Minssuung/BandLeadDevice/work_process/0_1.md

# 0_1. IMU 센서란?

> **핵심 질문: IMU는 "기울기"를 어떻게 측정하는가?**

---

## IMU(Inertial Measurement Unit)란?

IMU는 물체의 **움직임과 방향**을 측정하는 센서 모듈입니다.
내부에 보통 아래 3가지 센서가 함께 들어있습니다.

---

## 구성 센서 3가지

### 1. 가속도계 (Accelerometer)
- **무엇을 측정하나:** X, Y, Z 3축 방향의 가속도 (단위: m/s² 또는 g)
- **특징:** 정지 상태에서도 중력(g = 9.8 m/s²)을 측정함
  - 센서가 수평이면 Z축에만 중력이 걸림
  - 기울어지면 중력이 X, Y, Z에 분산됨
- **용도:** 정적(느린) 기울기 측정에 강함
- **단점:** 진동이나 충격에 민감 → 흔들리면 노이즈 발생

### 2. 자이로스코프 (Gyroscope)
- **무엇을 측정하나:** X, Y, Z 3축의 **각속도** (단위: °/s, 초당 몇 도 회전하는가)
- **특징:** 회전 속도를 측정 → 시간으로 적분하면 각도를 얻을 수 있음
- **용도:** 빠른 회전 동작 추적에 강함
- **단점:** 시간이 지날수록 오차가 누적됨 → **드리프트(drift)** 현상
  - 가만히 놔둬도 값이 천천히 변함

### 3. 지자기계 (Magnetometer)
- **무엇을 측정하나:** 지구 자기장의 방향 (나침반 역할)
- **용도:** Yaw(수평 회전) 각도의 절대 기준 제공 → 드리프트 보정
- **단점:** 주변 금속/전자기기에 영향받음 (실내에서 정확도 낮을 수 있음)

---

## 핵심 답변: IMU는 기울기를 어떻게 측정하는가?

```
가속도계 단독으로는:
  → 중력 방향을 기준으로 Roll(좌우 기울기), Pitch(앞뒤 기울기) 계산 가능
  → 하지만 흔들리면 부정확

자이로스코프 단독으로는:
  → 회전 속도를 적분해서 각도 추정 가능
  → 하지만 시간이 지나면 드리프트 누적

둘을 합치면 (센서 퓨전):
  → 가속도계로 저주파(느린 움직임) 보정
  → 자이로로 고주파(빠른 움직임) 추적
  → 서로의 단점을 보완 → 정확한 각도 출력
```

> **WT61C-TTL은 이 센서 퓨전을 내부에서 자동으로 처리해서
> Roll / Pitch / Yaw 각도를 바로 출력해줍니다.**

---

## Roll / Pitch / Yaw 란?

| 용어 | 회전축 | 일상 표현 |
|---|---|---|
| Roll | X축 | 좌우로 기울이기 (비행기 날개 기울기) |
| Pitch | Y축 | 앞뒤로 기울이기 (비행기 기수 올리기) |
| Yaw | Z축 | 수평 회전 (나침반 방향처럼 돌리기) |

---

## WT61C-TTL이 출력하는 데이터

| 데이터 | 항목 | 단위 |
|---|---|---|
| 가속도 | Ax, Ay, Az | g |
| 각속도 | Wx, Wy, Wz | °/s |
| 오일러 각도 | Roll, Pitch, Yaw | ° |

---

## 참고 자료
- [WitMotion WT61C-TTL 제품 페이지](https://www.wit-motion.com)
- [WitMotion GitHub SDK](https://github.com/WITMOTION/WitStandardProtocol_JY901)
