Minssuung/BandLeadDevice/work_process/미니_팔로우암_안정화_검증.md

# 미니 팔로우암 안정화 검증 (2026-06-11)

> 미니 팔로우암(=팔로워를 닮은 미니어처 조종용 팔, 리더암)으로 7축 텔레옵을 구현하고
> 통신·변환·안전·추종을 수치로 검증한 보고서.

## 0. 용어 정리

이 장치의 정확한 명칭은 **리더암(leader arm) / 마스터암**:
팔로워와 닮은 미니어처 팔을 **손잡이로 잡고 조종**하는 방식 (ALOHA / GELLO / SO-ARM 계열).
- "외골격(exoskeleton)"은 몸에 **착용**하는 형태를 가리키므로 부정확
- 컨트롤 분류: **joint-space retargeting** (리더 관절각 → 팔로워 관절각 1:1 복사),
  OpenArm ROS2 기준으로는 `forward_position_controller` 방식 + 자체 보간층

```
리더암 (사람이 손잡이로 움직임, 토크 OFF = 순수 엔코더)
  → 60Hz 폴링 (leader_arm.py / LeaderReaderThread)
  → 틱 차이 × 360/4096 × 부호 × 스케일 (+ 영점 오프셋)
  → 기존 안전 파이프라인 (동기화 보간 70°/s, 관절클램프, 충돌벽, freeze)
  → DYNAMIXEL 팔로워 7축
```

## 1. 하드웨어 식별 (실측)

| 항목 | 값 | 확인 방법 |
|---|-----|---|
| 서보 | **Feetech STS3215 계열** (다이나믹셀 아님) | P2.0 무응답 + P1.0 핑 응답, addr3=777 시그니처 |
| 프로토콜 | DXL Protocol 1.0 호환 프레임 @ **1M baud** | 전 baud 스캔 |
| 구성 | **양팔 × (ID1~7 관절 + ID8 그리퍼)** = 팔당 8축 | 어댑터 2개(CH343, 시리얼 5AE6053359 / 5AE6083659) 각각 ID1~8 응답 |
| 현재위치 레지스터 | **addr 56** (2B, 0~4095) | addr36은 상수(2640)=위치 아님, addr56만 ID별 상이·정지시 안정 |
| 포트 고정 | `/dev/serial/by-id/...5AE605...` / `...5AE608...` | ACM 번호 밀림 방지 (팔로워 OpenRB-150과 공존) |

## 2. 수치 검증 (실측 + 단위테스트)

### 2-1. 통신 성능 (실기기 측정)
| 항목 | 측정값 | 의미 |
|---|---|---|
| 8서보 일괄 읽기 | **2.5 ms/회** | 이론 최대 **400 Hz** |
| 운용 폴링 | 60 Hz (15ms 주기) | 충분한 여유 (6배) |
| 분해능 | **0.088°/틱** (4096틱/회전) | IMU 보정오차(수°)보다 1~2자릿수 정밀 |
| 체인 지연(이론) | 리더읽기 2.5ms + 틱 ≤50ms ≈ **~60ms** | IMU 경로(~100-150ms+센서융합)보다 짧음 |

### 2-2. 랩어라운드/변환 단위테스트 (6/6 통과)
0/4095 경계를 넘는 이동에서 ±360° 점프가 나지 않는지:
| 케이스 | ref→pos | 결과 | 판정 |
|---|---|---|---|
| 동일 위치 | 2048→2048 | 0.00° | ✓ |
| ±90° | 2048→3072 / 1024 | +90.00 / -90.00° | ✓ |
| **경계 넘는 +이동** | 4000→100 | **+17.23°** (–343 아님) | ✓ |
| **경계 넘는 -이동** | 100→4000 | **-17.23°** | ✓ |
| 경계 1틱 | 4095→0 | +0.09° | ✓ |

### 2-3. 기능 검증 (사용자 실기 확인 완료)
| 항목 | 결과 |
|---|---|
| 관절 순서 | 리더 ID1~7 = 팔로워 1~7, **1:1 매핑 맞음** |
| 부호 (반복 조정으로 확정) | `LEADER_SIGN = {1:-1, 2:+1, 3:-1, 4:+1, 5:-1, 6:+1, 7:-1}` |
| 영점 오프셋 | **모터5 = +90°** (시작 시 base 틱 이동 방식 → 팔로워/IMU모드 설정 불변) |
| 전체 7축 추종 | **사용자 확인 완료** ("오케이 확인완료") |
| 그리퍼(ID8) | 읽기/표시만 (팔로워 ID8=고정모터라 매핑 보류) |

### 2-4. 미실시 (리더 재연결 시 10초면 측정 가능)
- 정지 노이즈(p-p/σ): 검증 시점에 리더 USB 분리됨. 측정 스크립트 준비돼 있음.

## 3. IMU 웨어러블 vs 리더암 비교

| | IMU 웨어러블 | 리더암 |
|---|---|---|
| 측정 원리 | 자세(쿼터니언) → 보정축 분해 | 관절각 **직접 측정** (엔코더) |
| 보정 | functional 보정 + 2-포즈 재정렬 필요 | **불필요** (시작 시 기준 캡처만) |
| 짐벌락/드리프트 | 쿼터니언으로 해결했으나 지자기 환경 영향 | **원천 없음** |
| 정확도 | 보정축 오차 수° (어깨 8° 언더리드 잔존) | 0.088° 분해능, 축오차 개념 없음 |
| 갱신율 | ~30Hz (펌웨어 115200 후) | 60Hz (최대 400Hz) |
| 지연 | ~100-150ms | **~60ms** |
| 장점 | 장비 없이 맨팔 동작, 야외/이동 자유 | 정밀·즉답·무보정 |
| 약점 | 보정/장착 변동/센서융합 지연 | 장치 앞에 있어야 함 |

→ **리더암 = 정밀 기준기(ground truth)**: 같은 동작을 IMU와 리더로 비교하면 IMU 보정 오차를 정량 측정 가능.

## 4. 안전 (두 모드 공통 파이프라인 공유)

- 동기화 보간(경로모양 보존, 70°/s) · 관절클램프(±90~140°) · 팔꿈치 충돌벽(EEPROM 800틱)
- 리더 전용: 끊김 0.3s freeze → 복구 램프인 / **리더 오류 시 자동 전달중지** / 토크 OFF 강제(엔코더 모드)
- 전달 시작 시 모터5가 +90°로 부드럽게 이동(영점 정렬) — 정상 동작

## 5. 파일

| 파일 | 역할 |
|---|---|
| `esp_imu_pc_control/leader_arm.py` | FeetechLeader (open=핑+토크OFF, read_positions, wiggle_detect) |
| `esp_imu_pc_control/leader_scan.py` | 포트/baud/ID 자동 스캔 유틸 |
| `esp_imu_pc_control3.py` | LeaderReaderThread, 리더 연결 UI, "리더-팔로워" 전달 모드 (IMU 모드와 병존) |

---

# 부록: IMU 파이프라인 지그 검증 (리더암 = 기준기, 2026-06-11)

IMU 1/2/3을 리더암 링크(윗팔/아랫팔/손)에 고정하고 리더 엔코더(0.088°)를 정답으로
IMU 분해 파이프라인을 정량 평가. 리더 라벨로 **보정축 자동 추출**(fit_axes_from_compare.py,
합성데이터 검증: 축 복구 완벽·재평가 0.00°) 후 재분해.

## 결과 (운용범위 |각도|≤85°, 원형오차·상수오프셋 제거)

| 관절 | 동작범위 | RMS 오차 | 95%ile | 판정 |
|---|---|---|---|---|
| j1 어깨 | 128° | **1.74°** | 3.3° | ✅ |
| j2 어깨 | (대규모는 1차) | **0.90°** | 0.8° | ✅ (1차 대동작: 게인 0.995/상관 0.991) |
| j3 어깨 | — | **2.54°** | 4.6° | ✅ |
| j4 팔꿈치 | 209° | **10.6°** | 13.6° | ✅ (10Hz 빠른동작 스큐 포함) |
| j5 손목롤 | 237° | 56° | — | ⚠ 가지점프 전(0-30s)엔 **0.0°** |
| j6 손목 | 163° | 24° | — | ⚠ 동일 영향 |
| j7 손목 | 168° | 40° | — | ⚠ 동일 영향 |
| **지연** | — | **130-132ms** (교차상관, 상관 0.96-0.97에서) | | |

## 핵심 발견 2건

1. **파이프라인 무죄 증명**: 보정축만 정확하면 어깨/팔꿈치급 정확도(0.9~10°)가 나온다.
   사람 착용 시 오차의 주범은 보정/장착이지 소프트웨어가 아님.
2. **손목 가지점프 재현·규명** ⭐: j5가 0-30s 완벽(오프셋 0.0°) →
   **j6(손목피치) 대각도 통과 순간 +90° 가지로 점프 후 고착** (오프셋 추이로 시점 특정).
   자세는 정확하나 (θ5,θ6,θ7) 표현이 특이자세 근처서 비유일 → 구조적.
   = 기존 미해결 "ID7 한번씩 이상" 증상의 정체. 운용범위(±90 클램프) 안에서도
   특이 근처 통과 시 발생 가능 → **가지 연속성 스냅**(이전 출력에 가장 가까운 동등해 선택,
   이산 선택만이라 감김 불가) 또는 손목피치 운용제한이 다음 개선 후보.

## 디버깅 여담 (교훈)
- IMU2 "안 돈다"(비율 0.09) 소동 = 센서 데이터 일시 멈춤이 원인 (배치는 정상이었음).
  → 멈춤 검출을 도구에 내장할 것.
- 선형 상관계수는 ±180° 랩 + 상수오프셋에 완전히 속는다 → 각도엔 **원형 통계** 필수.
- 측정 시 "잡은 손은 바위, 움직이는 손은 달팽이" — 비고정 링크 출렁임이
  IMU간 시간차(10Hz)와 결합해 축 추정을 오염시킴.

도구: compare_imu_leader.py(동시 로깅), fit_axes_from_compare.py(자동 축적합+재평가),
      calibration_jig.json(지그 전용 — 사람용 calibration.json 불변).

---

# 부록2: B 프로토콜 (보정/평가 분리) + 센서 융합 한계 규명 (2026-06-11)

6차 fact-checker 처방 프로토콜로 재검증: 보정 캡처에서 축 적합 후 **동결**, 별도 캡처로 평가
(순환성 제거). 진행 중 센서 융합의 근본 한계를 속도별로 분리 실증.

## 핵심 수치

| 검증 | 결과 |
|---|---|
| 분해 솔버 (멀티스타트+FK게이트) | 직교축 FK잔차 **0.00%** (8.8%→0), 정확도 0.02° 유지, 2.7ms |
| 저속(<20°/s) 추적 | 중앙오차 **0.0°** — 소프트웨어 스택 무결 |
| 중속(20-50°/s) | 중앙 7.8° (≈130ms 지연 × 속도 = 지연 지배) |
| 동결축 품질 | 어깨 일관성 0.87-0.93, j4 0.89, j7 0.88 / 손목 축각 99/87/92°(직교 근접) |
| baud 115200 승급 | 성공 (KEY 언락 추가 후). 7→9-14Hz |

## 센서 융합 모드별 한계 (속도 분리 실측)

| 모드 | 정지 | 저·중속 | 고속/지속 동작 |
|---|---|---|---|
| **9축**(지자기) | 안정 | 서보 근접시 **~100° 홉** (배회 ±15, 자기치유 일부) | 동일 |
| **6축** | 1.6-1.9°/min ✅ | 손목단독 ≤3° ✅ | **yaw 영구 킥** (어깨 고속 휘두름 → j3 +40°), 지속 동작시 손목 상대 yaw ~27°/min 표류 |

**결론**: WT901 온보드 융합은 어느 모드든 "두 센서 사이 상대 yaw"를 활동 수 분 내
수십° 수준으로만 보장. 중력 관측 가능한 성분(어깨 굴곡/벌림)은 양호.
- 지그 검증 목적: 6축+중속으로 달성 (저속 0.0°)
- 사람 텔레옵: 9축(서보에서 멀고 자기치유) vs 6축(킥 위험) **착용 A/B로 결정** — 미결
- 근본 해법(로드맵): 관절구속 기반 상대 yaw 보정 또는 고속 raw 스트리밍+자체 융합

## 미결/메모
- 수신율 9-14Hz (목표 30) — 통합읽기 폴백 의심, 펌웨어 카운터로 진단 필요
- **j7 동작이 3회 시도 모두 범위 ~0.4°** — 사용자가 돌린 노브가 j7이 아니라 그리퍼(ID8)일 가능성,
  다음 세션에서 ID8 로깅 추가해 확인
- 켭처별 데이터: /tmp/B_calib(2168s), B_calib2, B_eval_final(1426샘플) 등, 동결축=calibration_jig_frozen.json

## 부록2 추가: 손목 최종 평가 (2026-06-11 저녁, 6축·동결축·보통속도)

| 관절 | 동작범위 | RMS | 95% | 판정 |
|---|---|-----|-----|---|
| j6 (손목 꺾기) | 163° | **9.5°** | 15.8° | ✅ (9Hz 지연 포함) |
| j7 (끝 롤) | 160° | 20.7° | 29.3° | △ 오프셋 ≤9° 안정, 지연·커플링 몫 |
| **j5 (손목 롤)** | 160° | 89° | — | ❌ 오프셋 폭주 (+2→+37→-47→+157, 분당 수십°) |

**구조적 결론**: imu2↔imu3 상대 yaw 드리프트(활동 중 ~27°/min)가 **롤 채널(j5)로 전부 투영**됨.
- j6은 중력으로 관측 가능 → 건강 / j7 부분 관측 → 중간 / **j5(전완축 회전)는 yaw 그 자체 → 무방비**
- 9축이든 6축이든 롤 채널이 희생자 (9축=홉, 6축=표류). 사람 밴드의 전완 회내/회외도 동일 운명.
- j7 엔코더는 정상 (식별 테스트 163.7° 등록 — 이전 캡처들의 0.4°는 동작 누락이었음)

**B 프로토콜 종결**: 7관절 전부 평가 완료. 오차 예산: 소프트웨어 0° + 지연(130ms×속도) + 롤채널 yaw드리프트.
**남는 개선 방향**: ①수신율 9→30Hz(지연↓) ②롤채널 드리프트 대책(느린 고역통과/재기준 워치독/관절구속 융합) ③사람 착용 9축 vs 6축 A/B

## 부록2 최종: println 병목 제거 후 (2026-06-11 밤) 🏆

**발견**: `sendImuPacket()`이 JSON(~400자)을 매 패킷 Serial.println → 115200 USB시리얼에서
패킷당 ~35ms 블로킹. **하루 종일의 9-14Hz, poll_fail 수천 건, "센서 멈춤", 130ms 지연이
전부 이 한 줄이 원인** (타 세션 제보로 확인).

**수정**: println 2초 스로틀 + 통합읽기 카운터 + 적응형 스킵.

| 지표 | 수정 전 | 수정 후 |
|---|---|---|
| 수신율 | 9~14Hz | **30.8Hz** |
| poll_fail | 수천 건 누적 | **0** |
| comb_ok/fail | (미계측) | 21,603 / **0** — 통합읽기 무결 |
| 지연 | ~130ms | **≤40ms (측정한계 이하, 상관 0.998)** |
| j1 추적 (237° 풀스윙 연속) | RMS 14-15° | **RMS 3.09° / 95% 7.7°** |

**최종 오차 예산 (확정)**: 소프트웨어 0° + 지연 ≈0 + **잔여 = 롤채널 yaw 드리프트만**
(j5 활동중 ~27°/min — 유일한 미해결, 대책: 고역통과/워치독/관절구속 융합/사람 9축 A/B)

## 부록3: 사람 착용 9축 vs 6축 A/B — 최종 결정 (2026-06-11 밤)

도구: drift_ab_test.py (중립 복귀 프로토콜, [30s 자유동작→중립 2s 정지]×5회, 리더암 불필요)

| 채널 | 6축 | 9축 | 결론 |
|---|-----|-----|---|
| 윗팔(절대) | 최종 85° / 최대 166° | **10.3° / 13.0° (추세 +1.0°/분)** | 9축 ~10× 우세 |
| 팔꿈치 채널 | 133° (+14°/분) | **4.1° (-0.5°/분)** | 9축 ~30× 우세 |
| 손목 채널 | 124° (+29°/분) | **13.5° / 21.6° (-0.3°/분)** | 9축 ~9× 우세 |

**최종 결정 (환경별 분리):**
- **사람 밴드 텔레옵 = 9축** — 몸은 서보 자석에서 멀어 지자기 자기치유가 작동, 추세 ≈0°/분(누적 없음).
  남은 4-21° 편차는 대부분 중립자세 재현오차. 빠른 동작에도 안전.
- **리더암 지그 검증 = 6축 + 중속** — 자석 cm 거리라 9축이 ~100° 홉. (IMU_USE_6AXIS 토글로 전환)
- 6축의 사람 착용 실패 원인 = 자연 동작(빠름)의 yaw 영구 킥 — 지그 실측과 일관.

**시스템 준비 완료 상태**: 30.8Hz + 9축 + 분해솔버(FK 0%) + 전 안전장치 + 드리프트 워치독
→ 밴드 텔레옵 실전 테스트 가능.
