Minssuung/BandLeadDevice/work_process/실물OpenArm텔레옵_작업보고서_2026-06-16.md

# 실물 OpenArm v1 텔레오퍼레이션 — 작업 보고서

> 작성일 2026-06-16 · 대상: 밴드형 IMU 리드디바이스 → **실물 OpenArm v1**(양팔, DAMIAO, CAN-FD) 텔레옵
> 시뮬(viz·MuJoCo) 검증을 마친 BandLead 텔레옵을 실물 OpenArm으로 옮겨, 환경 구축부터 실증·안전까지 진행한 기록.

---

## 0. 요약

미니 팔로우암(DYNAMIXEL)에서 검증한 IMU 텔레옵을 **실물 OpenArm v1**(caring_openarm 워크스페이스)으로 이식했다. ROS2 Jazzy 환경을 구축하고, 실물 CAN/모터를 연결해 기본 동작(관절 제어)을 확인했으며, **BandLead 텔레옵 어댑터**(IMU→JTC)와 **앱 텔레옵 탭**을 구현했다. fact-check로 안전 결함을 잡아 충돌 보호·E-stop을 보강했다.

| 단계 | 결과 |
|---|---|
| **환경 구축** | ROS2 Jazzy desktop+MoveIt, colcon 7패키지 빌드, venv | ✅ |
| **실물 연결** | CAN-FD(1M/5M) 양팔, 모터 16개 응답, bringup v1 activate | ✅ |
| **기본 동작** | 관절 제어(MoveIt 계획→JTC 실행) 실물 구동 | ✅ |
| **부호/매핑** | 우완 j1·j2 보정, j6↔j7 v1=스왑OFF(v2와 축 반대) | ✅ |
| **텔레옵 어댑터** | IMU→calib_ik→JTC, DRY/EXECUTE, 안전장치 | ✅ |
| **앱 텔레옵 탭** | 5패널·E-stop연동·기준재설정·시뮬뷰어 | ✅ |
| **안전(fact-check)** | 충돌 보호 P0·fail-closed·E-stop 직접감지·freeze | ✅ |
| **실증** | j1 추종 확인, j2 부호·그리퍼충돌 미해결(진행중) | ⚠ 일부 |

---

## 1. 목표 & 시스템 구성

```
[IMU 밴드 ×3] ─RS485─▶ [ESP32] ─UDP 4210─▶ [PC: 텔레옵 어댑터]
  (어깨/상완/전완)                          calib_ik 분해 → 7관절각
                                            부호/매핑 + 안전장치
                                                    │ ROS 토픽
                                                    ▼
                            [bringup: ros2_control + JTC + HW(CAN-FD)]
                                                    ▼
                                    [실물 OpenArm v1 우완 7-DOF + DAMIAO]
```

- **caring_openarm**: 실물 OpenArm v2 양팔 제어 colcon 워크스페이스(ROS2 Jazzy+MoveIt2+ros2_control). 실물은 **v1** 사용.
- **BandLead**: IMU 밴드(WT901C 9축) → ESP32 RS485 Modbus → UDP. calib_ik 멀티스타트 분해.

---

## 2. 환경 구축

| 항목 | 내용 |
|---|---|
| ROS2 | **Jazzy desktop + MoveIt** apt 설치 (Ubuntu 24.04 호환) |
| 빌드 | `OPENARM_MONITOR_BUILD_PEAK=0 ./bootstrap.sh` → colcon **7패키지**(openarm/bringup/bimanual_moveit_config/can/description/hardware/mujoco_hardware) |
| 서브모듈 | `.gitmodules`의 `git@github-woolimi:` SSH별칭 미설정 → `github.com` 우회 클론 |
| venv | `caring_openarm/.venv`(BandLeadDevice/.venv와 별개), 시뮬 패키지 6종 |
| 추가 IK/servo | `ros-jazzy-trac-ik-kinematics-plugin`·`pick-ik`·`ros2-control`·`moveit-servo`(rosdep 누락분) |
| 핵심 함정 | `setup.bash`는 bash 전용 — zsh에선 `bash -c 'source ...'`로 감싸야 ROS_DOMAIN_ID·rclpy 잡힘 |

**앱(openarm_monitor)**: `verify` 소프트웨어 코어 전부 통과(ROS 없이 시뮬 OK). `OPENARM_MONITOR_MODEL=v1`, `MOVEGROUP_LAUNCH=v1_real`.

---

## 3. 실물 연결 (CAN·모터·bringup)

| 항목 | 내용 |
|---|---|
| CAN 어댑터 | **PEAK PCAN-USB Pro FD** 2채널 — `peak_usb` 커널 드라이버 기본 인식(별도 드라이버 불필요) |
| CAN-FD 설정 | `can0`(우)/`can1`(좌) **1Mbps nominal / 5Mbps data** UP |
| 모터 점검 | `show_param` 양팔 **16/16 응답**(전원·CAN 정상) |
| bringup | `03.bringup.sh`(=`openarm.bimanual.launch.py use_fake_hardware:=false`) → ros2_control HW(CAN 단독소유) + JTC + `/joint_states` |
| ⚠ 모델 정정 | 처음 **v2로 bringup**했다가 실물이 **v1**임을 확인 → v1으로 재기동 |
| ⚠ 중력보상 | `no KDL chain openarm_body_link0→link7` → **gravity comp DISABLED**(v1/v2 공통 URDF base-link 이슈). 홈 근처 저속 운용 |
| ⚠ 재부팅 함정 | CAN은 재부팅 시 **DOWN**으로 복귀 → bringup 전 CAN-FD 설정 필수(→ `teleop` 함수에 자동화) |

---

## 4. 기본 동작 검증 (관절 제어 + 부호/매핑)

- **관절 제어 탭**: 슬라이더 → MoveIt 충돌회피 계획 → JTC 실행 → **실물 관절 이동 확인**(앱이 oa_movegroup_v1_real 자동 기동, controller-free라 bringup과 비충돌).
- **부호/매핑 (viz→실물 검증)**:
  - 우완 **j1(yaw)·j2(pitch) 부호** — 양팔 axis가 동일(미러 누락)이라 좌우 부호 반대 필요. j1은 userSign[-1]만으로 맞음(FLIP 시 이중반전 클램프), j2는 실물에서 부호 반대 발견(미해결).
  - **j6↔j7 스왑**: viz는 v2(j6=Y·j7=X), **v1은 축 반대(j6=X·j7=Y) → 스왑 OFF**가 맞음. signmap 기본값을 v1용으로 생성.
  - j2 가동범위 비대칭(우완 -10°~+190°): 안쪽 끝은 자기충돌 영역.

---

## 5. BandLead 텔레옵 어댑터 (`openarm_teleop_adapter.py`)

IMU UDP(4210) → `bridge`(calib_ik 분해 재사용) → 부호/매핑 → `/{side}_joint_trajectory_controller/joint_trajectory` **직접 발행**(MoveIt 우회 = 저지연).

| 기능 | 내용 |
|---|---|
| 분해 | bridge.calib_ik(멀티스타트·브랜치연속성·FK잔차게이트) 재사용 |
| 부호/매핑 | signmap JSON(`~/.local/share/openarm_monitor/teleop_signmap.json`) **실시간 reload**(10패킷마다 mtime) |
| 안전 | **DRY-RUN 기본**·stale-freeze(200ms)·속도클램프 180°/s·점프디바운스·관절한계 클램프 |
| 기준 | 차렷 자동기준(첫 패킷) + **SIGUSR1 즉시 재설정**(재시작 없음) |
| 시뮬 뷰어 | `--viewer` → MuJoCo 창(목표 자세 + 충돌점 빨강), DRY-RUN 미리보기 |

---

## 6. 앱 텔레옵 탭 (`webui/teleop.py` + `ros/teleop_proc.py`)

navbar `tab_teleop` 등록. 어댑터를 subprocess로 관리·모니터.

| 패널 | 기능 |
|---|---|
| 제어 | 시작/정지·팔(좌/우)·모드(DRY/EXEC)·스케일·속도·**시뮬 뷰어 토글** |
| IMU 상태 | 수신율·기준·패킷 + **[기준 재설정](즉시)** |
| 관절각 모니터 | raw→OA 실시간 막대(한계 빨강) |
| 부호/매핑 조정 | j1~7 부호·우완반전·**j6↔j7 스왑** 토글 → 저장(실시간 reload) |
| 안전 | 비상정지 + **전역 E-stop 연동** |

---

## 7. 관절 한계·충돌 방지 — OpenArm 표준 구조 & 어댑터가 자체 구현한 이유

### 7.1 OpenArm 표준(caring_openarm)은 어느 계층에서 하나
**관절값 제한:**
| 계층 | 강제? | 내용 |
|---|---|---|
| URDF (`v1_tcp.urdf` ← `joint_limits.yaml`) | ❌ 정의만 | `<limit>` lower/upper/effort/velocity. right_j1 -80~200°·j2 -10~190° 등 — 메타데이터 |
| MoveIt 계획 (OMPL) | ✅ 계획 시 | URDF 한계 + 속도/가속(`joint_limits.yaml`, 기본 0.1배) 존중한 궤적만 생성 |
| ros2_control JTC | ❌ | 계획 궤적 그대로 추종 — 위치 한계 클램프 **안 함**(`oa_ros2_controllers.yaml`은 추적오차 constraints만) |
| HW(`openarm_simple_hardware.cpp`) | ❌ | `write()`가 `pos_commands_` 클램프 안 함(게인 kp/kd만 `std::clamp`) |

**모터/프레임 충돌 방지:**
| 계층 | 방식 |
|---|---|
| SRDF (`openarm_bimanual.srdf`) | `disable_collisions` **28쌍**(인접 링크·그리퍼 손가락쌍) 제외, 나머지(양팔간·팔↔베이스 body_link0)는 검사 |
| MoveIt 계획 | OMPL이 SRDF 기반 self/환경 충돌 검사 → 충돌 경로 기각(계획만, 실행 중 미검사) |
| MoveIt Servo (`oa_servo_v1.launch.py`) | 실시간 **10Hz**, `self_collision_proximity 0.01m`·`scene 0.02m` 근접 시 정지 — **servo 실행 시만** |
| JTC / HW | ❌ 충돌 방지 **없음** |
| 그리퍼↔프레임 | SRDF에 손가락-프레임 쌍 **미정의** → planning_scene 외부 장애물로 따로 모델링해야 함 |

### 7.2 ⭐ 직접 JTC 발행(MoveIt 우회) 시 — 표준 보호가 전부 빠짐
OpenArm 표준의 관절 한계·충돌 방지는 **전부 MoveIt 계획/Servo 계층에만** 존재한다. 그런데 **BandLead 어댑터는 저지연을 위해 `/{side}_joint_trajectory_controller/joint_trajectory`에 직접 발행(MoveIt 우회)** 한다 → **URDF 한계도, SRDF/MoveIt 충돌 검사도 전혀 적용되지 않는다.**

→ 따라서 어댑터에 **자체적으로** ①URDF 관절한계 클램프 ②MuJoCo 실시간 충돌 검사를 넣은 것이 **필수**였다(아래 §8). 특히 그리퍼-프레임은 SRDF에도 미정의라 표준만으로는 절대 못 막는다.

## 8. 안전 — 어댑터 자체 구현 (fact-check & 충돌 보호 P0)

위 §7.2대로 텔레옵은 MoveIt 표준 보호를 우회하므로 어댑터에 직접 구현. **fact-check가 결함을 잡았다:**

| fact-check 발견 | 수정(P0) |
|---|---|
| 충돌검사 `ncon>base`가 그리퍼 손가락쌍 접촉에 흔들려 **검출 누락** | base 폐기 → **우완 collision 연루 접촉만 + 손가락쌍 제외 + 거리 판정** |
| **fail-open**(scene 없으면 무방비 publish) | **fail-closed**(충돌검사 불가 시 EXECUTE 거부) |
| E-stop이 **0.3s UI 폴링** 의존(브라우저 의존) | `source.estop()`→플래그 파일→**어댑터 직접 폴링**(매 패킷) |
| freeze가 "되돌아가기" 위험 | 충돌 시 **현재 실측 자세(/joint_states) 홀드** |

**그리퍼-프레임 충돌**: 모델 collision이 실물보다 **~5cm 큼**(실물 차렷 5cm 여유인데 모델 0mm) → **오프셋 보정**(실물거리=모델거리+5cm, 실물 1cm에서 차단). 정밀 검증은 시뮬 뷰어로 닿는 자세 확인 중.

### 8.1 실시간 성능 — 충돌 검사가 텔레옵을 늦추지 않는가
**측정 결과 충분히 빠름.** 충돌 검사 1회 = MuJoCo `mj_forward` **0.082ms**(≈12kHz 처리 여력). IMU 패킷은 30~50Hz(20~33ms 간격)로 들어오므로, 검사가 명령보다 **약 250배 빠르다** → 검사를 매 패킷 돌려도 텔레옵 추종에 지장 없음.

**빠른 이유:** 중력·관성으로 팔이 떨어지고 흔들리는 것까지 적분하는 **동역학 시뮬(`mj_step`)이 아니라**, "이 자세에서 어디가 닿나"만 보는 **자세 계산 + 접촉 검사(`mj_forward`)만** 수행하기 때문. 즉 물리 시뮬이지만 가볍다.

| | 시간 |
|---|---|
| 충돌 검사 1회 | **0.082ms** |
| IMU 명령 간격 | 20~33ms (30~50Hz) |
| 여유 | 약 250배 (검사 후 ~19.9ms 남음) |

→ 실측: DRY-RUN 시뮬 뷰어도 충돌 검사를 켠 채 끊김 없이 IMU를 추종(목표OA 실시간 갱신).

---

## 9. 실증 결과

| 항목 | 결과 |
|---|---|
| 관절 제어(MoveIt) 실물 구동 | ✅ |
| 텔레옵 DRY-RUN→EXECUTE | ✅ **사람 팔 → 실물 추종 동작 확인** |
| j1(어깨 yaw) 부호 | ✅ 수정 후 정상 추종 |
| **j2(어깨 pitch) 부호** | ⚠ 반대 — 한계 비대칭(-10~190)이라 단순반전 시 클램프, 미해결 |
| **그리퍼-프레임 충돌** | ⚠ 손목 굽힘 시 그리퍼 슬라이더가 프레임에 닿음 — 오프셋 보정 적용, 정밀화 진행중 |
| 중력보상 | ⚠ OFF(KDL) — 큰 자세 처짐, 홈 근처 저속 한정 |

---

## 10. 미해결 & 다음

| 우선 | 항목 |
|---|---|
| P0 | j2 부호(한계 비대칭) 해결 · 그리퍼-프레임 충돌 정밀화(닿는 자세 관절각 확정) |
| P1 | 충돌 **경로 보간 검사**(현재 목표만) · 홈복귀 자동화(어댑터 JTC 독점) · IMU yaw 드리프트 |
| P2 | 중력보상 복구(KDL base-link 수정) |

---

## 부록 — 운영(재부팅 후 시작)

```bash
teleop          # CAN-FD + bringup + 앱 한 번에 (sudo 비번 1회)
# → 로봇 초록불 확인 → ESP32 켜기 → 앱 텔레옵 탭에서 '시작'
teleop-stop     # 전체 종료
```
- 초록불 안 뜸 → ① 하드웨어 E-stop 풀기 ② `teleop-stop`→`teleop` ③ `ip -br link show can0`(DOWN이면 CAN 문제)
- 상세: `caring_openarm/텔레옵_운영가이드.md`

**관련 문서**: `종합검증보고서_BandLead텔레옵_2026-06-15.md`(미니암 4축 검증) · `시뮬연동검증_밴드리드디바이스_2026-06-15.md`(viz·MuJoCo 시뮬) · 메모리 `caring-openarm-integration`
