Minssuung/BandLeadDevice/work_process/일일보고_2026-06-11.md

# 일일 작업 보고 — 2026-06-11

> 리더암 도입부터 센서 융합 모드 확정까지. 하루 동안 **추적 정확도 14~15° → 3.1° RMS**,
> **수신율 9Hz → 30.8Hz**, **미해결 "손목 가끔 이상" 증상의 근본 원인 규명·해소**.

## 오늘의 핵심 수치 (Before → After)

| 지표 | 아침 | 저녁 | 비고 |
|---|---|---|---|
| 수신율 | 9~14Hz 널뛰기 | **30.8Hz 안정** | println 병목 1줄 제거 |
| 통신 지연 | ~130ms | **≤40ms (측정한계 이하)** | 상관 0.998 |
| 어깨 추적 (237° 풀스윙) | RMS 14~15° | **RMS 3.09° / 95% 7.7°** | 엔코더 대비 실측 |
| 분해 실패율 (FK잔차>5°) | 8.8% | **0.00%** | 멀티스타트+게이트 |
| 모터 속도 | 82°/s | **206°/s** | 사람 팔속도 대응 |
| 드리프트 (사람 착용, 9축) | (미계측) | **추세 ≈0°/분** | 누적 없음 확인 |

---

> 상세 기술 검증·개선 내용은 별도 문서: **`IMU_정확도검증_개선보고.md`**
> (검증 방법 = IMU 센서를 리더암에 직접 부착, 쉬운 설명 버전)

## 1. 검증 체계 구축 — "리더암 = 기준기(0.088°)" (IMU를 리더암에 부착)

- `compare_imu_leader.py`: IMU vs 리더 엔코더 동시 로깅 (쿼터니언 포함, 경량 24Hz+)
- `fit_axes_from_compare.py`: **리더 라벨로 IMU 보정축 자동 추출** + 재분해 평가
  — 합성데이터 검증: 축 복구 완벽, 재평가 0.00°/게인 1.000/상관 1.000
- `drift_ab_test.py`: 사람 착용 드리프트 측정 (중립 복귀 프로토콜, 리더암 불필요)
- 방법론: fact-checker 처방 반영 — 보정/평가 캡처 분리(순환성 제거), 원형 통계(±180 랩 인지), 속도-오차 분해

## 2. 분해기(calib_ik) 완성 — 정확도 개선의 본체

| 문제(실측) | 해법 | 결과 |
|---|---|---|
| 시드±60° 단일밴드가 큰 손목회전서 해를 가둠 (FK잔차>5° **8.8%**, 최대 41°) | **멀티스타트**(18 시작점: 듀얼 ±180 × θ2거울) + 시작점별 밴드 110° | 직교축 **0.00%** |
| 가짜 해가 선택될 위험 | **FK잔차<2° 게이트** (진짜 해만 후보) | 잔차 라이브 로깅 |
| 특이자세 통과 시 가지(branch) 점프 | **가지 연속성**(이전 출력 최근접 후보, 이산 선택만=감김 불가) + 정준해 폴백 | 검증됨 |
| 한 프레임 점프가 모터로 | 점프 디바운스 (>45°는 3프레임 확인 후 추종) | — |
| 성능 | 2.7ms/회 (예산 33ms) | — |

저속(<20°/s) 추적 중앙오차 **0.0°** — "소프트웨어는 오차를 만들지 않는다" 실증.

## 3. 센서 융합 — 미해결 증상의 근본 규명과 모드 확정 ⭐

**여정**: 손목 +90° 오프셋 발견 → 가지점프 가설 → FK잔차로 기각 → **지자기 상대 yaw 드리프트 확정**
(오프셋이 93~129° '배회' + FK잔차 0 = 자세는 정확, 센서간 상대 방위가 표류)

**6축 전환 실험** (fact-checker GO-WITH-CHANGES, 공식 SDK로 레지스터 검증):
- 손목 단독 ≤131°/s: 오프셋 ≤3° (거의 완벽)
- 그러나 빠른 팔 휘두름: **yaw 영구 킥** (+40°/이벤트), 지속 동작 시 ~27°/분 표류

**사람 착용 A/B (최종 결정)**:

| 채널 | 6축 | 9축 |
|---|-----|-----|
| 윗팔 | 최대 166° | **13°, +1.0°/분** |
| 팔꿈치 | 133° | **4.1°, -0.5°/분** |
| 손목 | 124°, +29°/분 | **21.6°, -0.3°/분** |

→ **사람 밴드 = 9축** (자석에서 멀어 자기치유 작동, 누적 0) / **지그 검증 = 6축+중속** (자석 옆).
펌웨어 `IMU_USE_6AXIS` 토글로 1글자 전환. **"손목/ID7 가끔 이상" 장기 미제 사건 종결.**

## 4. 통신 — 한 줄의 기적

- 병목: `sendImuPacket()`이 JSON(~400자)을 **매 패킷 Serial.println** → 115200에서 패킷당 ~35ms 블로킹
- 그동안의 9~14Hz, poll_fail 수천, "센서 멈춤", 130ms 지연이 **전부 이 한 줄** (타 세션 제보로 확인)
- 수정: println 2초 스로틀 + 통합읽기 카운터(comb_ok/fail) + 적응형 스킵
- 결과: **30.8Hz, poll_fail 0, comb_fail 0** (통합읽기는 처음부터 무결했음)

## 5. 안전/품질 추가분

- **팔꿈치 충돌벽**: 모터 EEPROM 위치한계 800틱(실측) — 앱·기준자세와 무관한 영구 벽 + 소프트클램프 140°
- **위치 도메인 슬루**: 베이스 캡처가 틀려도 모터 슬램 불가 (각도클램프의 사각 보완)
- 베이스 캡처 로그(범인 추적용), 드리프트 워치독(°/분 흐름 경고), 센서 재부팅 감지(60°+ 점프 경고)
- 속도 상향: PV 150(206°/s), 추종 180°/s — 안전장치 위에서 해방

## 버그/교훈 (재발 방지)

1. **각도 비교에 선형 통계 금지** — ±180 랩+오프셋에 상관계수가 완전히 속음 → 원형 통계 필수
2. **네트워크 버스트**: PC 도착시각으로 속도 계산하면 가짜 스파이크 → ESP 타임스탬프 사용
3. 핫루프 Serial 출력은 통신 전체를 죽인다 (35ms/패킷)
4. "센서가 안 돈다" 진단 전에 **데이터 멈춤(stale)부터 검사** (IMU2 오진 소동)
5. 측정 시 "잡은 손은 바위, 움직이는 손은 달팽이" — 비고정 링크 출렁임이 축 추정 오염
6. 분해 순서는 물리 체인 순서대로 (손목 j5→j6→j7)

## 남은 과제

1. ESP 간헐 무응답(전원/케이블 의심) 관찰
2. 사람 착용 정확도 정량(밴드+물리 기준자세) — 9축 확정 후 첫 실측
3. 장기: 관절구속 기반 상대 yaw 보정 (9축 홉/6축 킥 모두 해소하는 정공법)
4. 그리퍼 채널(리더 ID8) 활용

**fact-checker 호출 3회** (6축 설계 GO-WITH-CHANGES / 검증방법론 감사 / 분해기 수정 검증) — 전부 반영.
