Minssuung/BandLeadDevice/work_process/종합검증보고서_BandLead텔레옵_2026-06-15.md

# BandLead IMU 텔레오퍼레이션 — 종합 검증 보고서

> 작성일 2026-06-15 · 대상: 밴드형 리드디바이스(IMU) → 미니 팔로우암(DYNAMIXEL) 텔레옵, 및 실물 OpenArm 전환 시뮬 검증
> 본 문서는 그간 개별 진행한 **통신·안전·정확도·기구학시뮬·물리시뮬** 검증을 한 곳에 묶은 상위 보고서다. 세부는 §9 부록 링크 참조.

---

## 0. 요약 (Executive Summary)

팔에 착용한 3개 IMU 밴드(WT901C, 9축) 동작을 ESP32(RS485 Modbus)→UDP→PC(calib_ik 분해)→7관절 미니암으로 **거의 동기식**으로 추종시키는 텔레옵을, "사람이 움직이는 대로 즉시 따라오는" 수준까지 끌어올리고 4개 축(통신/안전/정확도/시뮬)으로 검증했다.

| 검증 축 | 핵심 결과 | 판정 |
|---|---|---|
| **① 통신·지연** | 종단지연 130→**113ms**, 수신율 32→**57.8Hz**, 끊김 7.8/s→**0** | ✅ 동기식 체감 달성 |
| **② 안전장치** | IMU 끊김/단일stale/복구/정합성 4종 결함주입 **전부 통과** | ✅ 실물 결함주입 검증 |
| **③ 정확도** | 7관절 중 **6관절 B등급**, j3는 측정한계(센서 무결 입증) | ✅ 시스템 결함 아님 |
| **④ 기구학 시뮬(viz)** | 매핑·부호·작업공간·연속성·교차오염·자기충돌 정량화(SV1~7) | ✅ OpenArm 적용성 확인 |
| **⑤ 물리 시뮬(MuJoCo)** | torque-off=낙하(최대 183°) 발견, 위치홀드/홈복귀=낙하 0° 실증 | ✅ 실물 안전정책 확정 |

**한 줄 결론:** 미니 팔로우암 텔레옵은 통신·안전·정확도·시뮬 4축에서 검증 완료. 실물 OpenArm 전환을 위한 기구학(부호/매핑/작업공간)·물리(낙하/홀드) 시뮬까지 마쳤고, 다음 단계는 caring_openarm 어댑터 구현이다.

---

## 1. 시스템 구성 & 검증 범위

```
[사람 팔: IMU 밴드 ×3]  ──RS485 Modbus(0x0D 폴)──▶ [ESP32]
        (어깨/상완/전완, WT901C 9축)                  │ UDP
                                                       ▼
                                  [PC 앱 esp_imu_pc_control3.py]
                                   · OneEuro 필터 · calib_ik 분해(7관절각)
                                   · 속도클램프 180°/s · 점프디바운스 · stale freeze
                                                       │
                                                       ▼
                                       [미니 팔로우암 7-DOF (DYNAMIXEL)]
```

검증은 **3계층**으로 분리 — 각 계층이 보는 것이 다르다:

| 계층 | 도구 | 검증 대상 |
|---|---|---|
| **통신/제어** | 실물 미니암 + 슬로모 + gapprobe | 지연·수신율·끊김·안전 결함주입 |
| **기구학 시뮬** | viz(three.js, OpenArm URDF) + bridge(calib_ik) | 매핑·부호·작업공간·연속성·교차오염 (SV1~7) |
| **물리 시뮬** | MuJoCo(OpenArm MJCF, 8kg, 중력) | 중력낙하·실패안전·중력보상·접촉/자기충돌 (MV1~) |

---

## 2. ① 통신·지연 검증

### 2.1 종단지연 (폰 슬로모 240fps, ROI 모션에너지 상호상관)

| 단계 | 영상 | 조건 | 기본지연(중앙값) | 큰 휘두름 |
|---|---|---|---|---|
| 1차(개선전) | IMG_4967 | 32Hz·LPF·20Hz틱 | 130ms (103–175) | 262–292ms |
| **2차(2단계후)** | **IMG_4969** | **32Hz·OneEuro·100Hz틱** | **113ms (88–125)** | 상한 175→125로 수렴 |
| 3차(쿼터니언후) | IMG_4970 | 54Hz | 129ms (117–148) | 측정오차(±15–20ms) 내 동일 |

→ OneEuro+100Hz 틱으로 **상한 지연(끊김 체감의 원인)을 175→125ms로 수렴**시킨 것이 "동기식" 체감의 핵심. 기본지연 130→113ms.

### 2.2 통신 품질 (imu_gap_probe.py — UDP 도착간격 분석)

| 단계 | 조건 | 수신율 | 끊김(80ms↑) | 도착간격 p99 | poll_fail |
|---|---|---|---|---|---|
| 개선전 | WiFi 절전ON·정지 | 32Hz | **7.8건/초** | 202ms | 0 |
| 개선후 | 절전OFF·정지 | 30.7Hz | ~5건/분 | 121ms | 0 |
| **최종** | **절전OFF·54Hz·동작중** | **57.8Hz** | **0** | **54ms** | 0.6% |

→ "툭툭 끊김"의 정체는 **WiFi 절전(DTIM)의 ~200ms 버스트**였고, 절전OFF + 폴주기(RRATE 0x0D) 조정으로 해소. 팔을 휘저어 몸이 RF를 가려도 끊김 0 (A2b 합격).

> 📹 슬로모 비교영상: `IMG_4967.mov`(개선전) / `IMG_4969.mov`(2단계후) / `IMG_4970.mov`(54Hz)

---

## 3. ② 안전장치 검증 — 실물 결함주입

실물(토크 ON)에서 실제로 IMU 선을 뽑고/재연결하며 안전로직을 강제 발화시킨 결과:

| 테스트 | 주입 방법 | 실측 결과 | 판정 |
|---|---|---|---|
| **D1 전체끊김** | IMU 데이지체인 전체 분리 | "IMU 끊김 — freeze" 로그 + 정지 | ✅ 통과 |
| **D1a 단일stale** | 끝 IMU(imu3)만 분리(나머지 패킷 지속) | STATUS avail=1인데 **age로 감지** → freeze | ✅ 통과 |
| **D2 복구** | 선 재연결(센서 재부팅·yaw리셋) | 64° 급변 경고 + 점프디바운스 보류 + 램프인 15°/s | ✅ 통과 |
| **W1 정합성** | 전달 시작 시 모터 베이스 2회 읽기·직전 goal 대조 | "모터 베이스 캡처(정합 OK)" 확인 | ✅ 작동확인 |

→ **단순 "패킷 유무"가 아니라 패킷이 와도 값이 늙으면(age) 감지**하는 D1a가 핵심. 데이지체인 부분 고장을 잡아낸다.

> 📊 자료: `결함주입_안전테스트.csv`

---

## 4. ③ 정확도 검증

### 4.1 사람 착용 측정 (HM, 3회)

7관절 중 **6관절 B등급**. 남은 j3(상완 yaw)의 텔레옵 측정 드리프트(−2.35°/min 등)가 등급을 낮췄는데, 이것이 **시스템 결함인지 측정 한계인지**를 별도 실험으로 분리했다.

### 4.2 j3 = 측정 한계 (센서 무결 입증)

IMU를 책상에 5분 정지(자세변수 0)시켜 순수 센서 yaw 드리프트만 측정:

| 회차 | imu1 | imu2 | imu3 | 비고 |
|---|---|---|---|---|
| 1회차 | −0.03 | +0.15 | −1.17 dpm | imu3 240s에 −5.6° 일회성 자기교란 홉 |
| 2회차 | 0.00 | 0.00 | 0.00 | 세 IMU 최대편차 **0.0°** 무드리프트 |

→ **정지 센서 드리프트 ≈ 0.** 즉 텔레옵에서 보인 j3 드리프트는 100% 비-센서 요인(사람의 정지자세 재현오차 또는 동작 yaw킥). **센서·시스템 결함이 아니라 사람-측정의 한계.** (※ fact-checker가 권고했던 HPF 보정은 불필요로 판명 — 센서가 무결하므로.)

> 📊 자료: `20260612_*_HM_human.csv/svg` (3회), `정지센서드리프트_실측.csv`, 세부 `IMU_정확도검증_개선보고.md`

---

## 5. ④ 기구학 시뮬 (viz, SV1~7) — OpenArm 적용성

viz(three.js + OpenArm URDF + bridge의 calib_ik)로 **실물 OpenArm에 부호/매핑이 맞는지, 작업공간을 벗어나는지**를 사람 동작 입력으로 검증.

| 시나리오 | 검증 | 결과 |
|---|---|---|
| SV1 순수동작 | 단축 동작이 단축 관절에만 | 매핑 확정: jointMap j6↔j7 스왑 |
| SV1 부호 | OpenArm 부호 방향 | userSign j1·j4·j6 반전 확정 |
| **SV2 교차오염** | 한 축 동작이 타축 누출 | **보정축 입력 0% 누출**(합성 입증). 사람 누출분은 부정확 동작이 원인 |
| **SV3 작업공간** | OpenArm 관절한계 초과 | **손목 303% 초과** — 펜스/스케일 정책 필요 |
| SV5 반복성 | 같은 자세 재현 편차 | (반복 측정) |
| **SV6 자기충돌** | 팔 모으는 자세 | 기구학으론 미검출 → MuJoCo로 이관(§6.4) |

> 📹 **사용자 촬영 데모영상**: `시뮬텔레옵데모.mp4` — 좌: 사람이 IMU 밴드 착용하고 팔 동작 / 우: OpenArm 3D 모델이 실시간 추종. **"사람 → OpenArm 동기 추종"을 한 화면에 담은 핵심 시연.**
> 📊 SVG: `SV3_workspace.svg`, `SV6_self_collision.svg`

---

## 6. ⑤ 물리 시뮬 (MuJoCo) — 실물 안전정책 확정

viz(기구학)는 강체를 명령 위치에 고정 → 중력·접촉·관성을 못 본다. MuJoCo(OpenArm MJCF, 8.0kg, 중력 −9.8)로 **물리**를 검증.

### 6.1 핵심 발견: OpenArm은 "torque-off = 안전"이 성립 안 함

토크 OFF 3초 낙하 (대표 자세):

| 자세 | 최대 관절낙하 | 손끝 추락 | 최대 속도 |
|---|---|---|---|
| 중립(팔 아래) | 28° | 0.9cm | 163°/s |
| 팔 앞 수평 | 90° | 62cm | 1535°/s |
| **팔 들어올림** | **183°** | **81cm** | 3844°/s |
| 팔꿈치만 90° | 92° | 38cm | 2746°/s |

→ 미니암(DYNAMIXEL: torque-off=멈춤)과 **정반대**. OpenArm은 거의 모든 자세에서 73~183° 낙하.

### 6.2 안전정책 실증 — 위치홀드 / 홈복귀

| 정책 | 결과 | (비교) torque-off |
|---|---|---|
| **(A) 위치 홀드**(텔레옵 끊김 시 freeze 실체) | 편차 0.00~0.06°, 외란에도 복귀 | 90~183° 낙하 |
| **(B) 홈 복귀 셧다운**(정상 종료) | 홈 도착오차 0.00°, 40°/s 제어하강 | 최대 5112°/s 추락 |

→ **위치제어가 토크를 유지하면 중력은 자동으로 버틴다**(별도 중력보상 모델 불필요). 사용자 제안("끊기면 이전 관절값으로 대기")이 물리적으로 옳음을 실증.

### 6.3 종료 상황별 안전정책 (확정)

| 상황 | 정답 정책 | 검증 |
|---|---|---|
| 텔레옵 끊김 | 위치 홀드(토크 유지) | ✅ 낙하 0° |
| 정상 종료 | 홈 복귀 후 토크오프 | ✅ 40°/s 제어하강 |
| e-stop | 그 자리 위치 홀드 | ✅ |
| 정전 | 모터 브레이크(하드웨어) | ❌ 시뮬 불가 — HW 필수 |

> ⚠ **미니암의 "이상 시 torque-off"는 OpenArm 이식 금지**(낙하). "토크 유지+홀드" 또는 "홈 복귀"로 재설계 필수.

### 6.4 자기충돌 (viz SV6 자세 → MuJoCo 접촉)

팔을 몸통 쪽으로 모으는 자세에서 **261/480 샘플(54%) 충돌** — right_link1↔link3(어깨 겹침), 팔링크↔베이스. 사람의 자연스러운 동작이 OpenArm에선 자기충돌 → **실물 자기충돌 펜스 필수.**

---

## 7. 영상·자료 인덱스

### 7.1 영상

| 파일 | 위치 | 내용 |
|---|---|---|
| **시뮬텔레옵데모.mp4** | 보고서자료_2026-06-12/ | ⭐ 사람 IMU 착용 → OpenArm viz 실시간 추종 (사용자 촬영) |
| IMG_4967/4969/4970.mov | (폰) | 종단지연 슬로모 비교 (개선전/2단계/54Hz) |
| **arm_up_COMPARE.mp4** | sim_mujoco/videos/ | ⭐ 팔들기 torque-off 낙하 vs 중력보상 유지 나란히 |
| arm_up_OFF / GRAVCOMP / arm_forward_OFF | sim_mujoco/videos/ | 자세별 낙하 단독 |
| **shutdown_COMPARE.mp4** | sim_mujoco/videos/ | ⭐ 종료 시 토크오프 추락 vs 홈복귀 안전하강 |
| shutdown_OFF / shutdown_HOME | sim_mujoco/videos/ | 셧다운 정책 단독 |
| **wrist_COMPARE.mp4** | sim_mujoco/videos/ | ⭐ 손목 작업공간 초과 대책: 펜스 vs 스케일다운 |
| wrist_FENCE / wrist_SCALE | sim_mujoco/videos/ | 손목 정책 단독 |
| **self_collision.mp4** | sim_mujoco/videos/ | ⭐ SV6 자세 자기충돌 지점(빨간점) |

### 7.2 측정 자료 (CSV/SVG/PNG)

| 자료 | 내용 |
|---|---|
| 종단지연_슬로모실측.csv | §2.1 지연 3단계 |
| 통신품질_gapprobe.csv | §2.2 통신 품질 3단계 |
| 결함주입_안전테스트.csv | §3 안전 4종 |
| 정지센서드리프트_실측.csv | §4.2 센서 무결 입증 |
| 20260612_*_HM_human.csv/svg ×3 | §4.1 정확도 HM 3회 |
| SV3_workspace.svg / SV6_self_collision.svg | §5 기구학 시뮬 |
| MuJoCo_낙하시퀀스.png / 안전셧다운비교.png / 자기충돌.png | §6 물리 시뮬 정지컷 |
| 시뮬텔레옵데모_프레임.png | §5 데모영상 대표프레임 |

---

## 8. 결론 & 실물 OpenArm 전환 함의

1. **미니 팔로우암 텔레옵은 4축(통신/안전/정확도/시뮬) 검증 완료.** 동기식 체감(113ms·57.8Hz), 결함주입 통과, 6/7 B등급(j3는 측정한계).
2. **실물 OpenArm 전환 준비됨** — 기구학(부호/매핑/작업공간/자기충돌)·물리(낙하/홀드/홈복귀) 시뮬로 적용성과 안전정책을 미리 확정.
3. **안전정책 이식 주의:** 미니암의 "이상 시 torque-off"는 OpenArm에 **그대로 옮기면 낙하**. "위치 홀드 / 홈 복귀 / 브레이크"로 재설계.
4. **다음 단계 = caring_openarm 어댑터** — caring_openarm(실물 OpenArm 제어 워크스페이스)에는 E-stop·중력보상(Zero-G/MIT임피던스)·속도클램프·충돌회피·MuJoCo 통합이 **이미 구현**되어 있다. 새로 만들 것은 `IMU UDP→calib_ik→7관절각(viz 확정 부호/매핑)→ROS 토픽` **어댑터 + IMU 신선도 stale-freeze 래퍼**뿐. (세부 [[caring-openarm-integration]])

---

## 9. 부록 — 세부 보고서 링크

| 영역 | 문서 |
|---|---|
| 텔레옵 종합 테스트 | `밴드형리드디바이스_미니팔로우암_텔레옵테스트_2026-06-12.md` |
| 지연 개선 | `지연개선_2026-06-12.md` |
| 정확도 | `IMU_정확도검증_개선보고.md` |
| 기구학 시뮬 플랜 | `시뮬검증_테스트플랜_OpenArm_2026-06-15.md` |
| 물리 시뮬 플랜 | `MuJoCo물리검증_테스트플랜_2026-06-15.md` |
| Jira(IMU 지연) | `jira_IMU통신지연_작업정리_2026-06-12.md` |
| 검사 기준서 | `검사기준서_미니팔로우암_2026-06-12.md` |
| OpenArm 전환 게이트 | `미니암_테스트플랜_OpenArm전환게이트_2026-06-12.md` |
