Minssuung/BandLeadDevice/work_process/보고서자료_2026-06-12/진행상황_2026-06-12_추가분.md

# 진행 상황 — 2026-06-12 추가분

> 기존 체크리스트(캘리브레이션~팔꿈치 재보정)는 전부 유효. 단 "통신 31Hz, 지연 0.04초"는 아래로 갱신.

## 갱신 (기존 항목 수치 변경)

🔄 **통신 개선 (갱신)** — 31Hz → **54Hz** (Modbus 쿼터니언-온리 폴링, 응답 53B→13B). 동작 중 실측 57.8Hz·끊김 0건/분·실패 0. **종단지연(사람→로봇) 113ms 실측** (폰 슬로모 240fps 상호상관, 88~125ms)

## 신규 (2026-06-12)

✅ **PC 와이파이 절전 OFF** — "툭툭 끊김"의 진범 규명·해결. 패킷 도착이 ~200ms 뭉텅이→균일 31ms, 끊김 이벤트 ~24배 감소 (nmcli 영구 적용)

✅ **오일러 스케일 버그 수정** — 펌웨어가 각도 레지스터를 1.82배 과장 전송하던 버그 발견·수정 (raw/100 → raw/32768×180, 실기 6값 0.02° 일치 검증). 쿼터니언(IK) 경로는 무영향이라 텔레옵은 그동안 정상. ⚠ 과거 오일러 기반 수치(구 드리프트 CSV 등)는 ÷1.82 필요

✅ **안전장치 실물 검증 (결함 주입)** — 전달 중 일부러 고장 내서 작동 확인: 전체 IMU 끊김→freeze / **한 센서만 사망(패킷은 정상 수신 지속)→freeze** / 복구 시 yaw리셋 경고+점프 보류+저속 램프인. "정상처럼 보이는 죽은 센서"를 신규 age 필드가 잡음

✅ **안전장치 신규 4종** — 명령-실위치 괴리 워치독(지속 30°+ 괴리 시 freeze), 베이스 정합성 게이트(2회 읽기 대조+직전 대비 30° 점프 시 시작 거부), 센서별 신선도(0.4s), 전달 시작 램프인(15°/s)

✅ **검사 프레임워크 구축** — 앱 내장 [검사 기록](20Hz CSV) + 자동 KPI 판정기(inspection_report.py, 자기검증 34/34). 사람 착용 한 번의 기록으로 배회(K4)+드리프트(K5) 동시 산출, Space키 정지 마크

✅ **정확도 정량 측정 (사람 착용)** — KPI 측정 종합 C (j3 드리프트 2.35°/min, j4/j5 배회 1.6~2.1°). **단, 센서 정지 드리프트 실측 0.00°/min(2회)으로 원인이 센서가 아닌 동작/측정 방법으로 규명** → 중속·고정자세 측정 시 B 예상 (확정 측정 1회 남음)

✅ **센서 무죄 입증 (정지 드리프트 실측)** — IMU 3개 책상 정지 5분×2회: yaw 드리프트 전부 0.00°/min. 9축 자기치유 우수 확인. 센서 보정(필터) 불필요 결론

## 미결 (다음)

- B등급 확정 측정 1회 (중속 + 정지 시 팔 고정)
- j3 텔레옵 드리프트의 원인 분리 (자세 재현 오차 vs 동작 yaw 킥 — 천천히 동작 테스트)
- viz 시뮬 B안 (OpenArm URDF + 최신 분해기 연결)

## 첨부 자료 (보고서자료_2026-06-12/)

검사보고서_HM_3회.md + SVG 그래프 3개 / 원시 CSV 3개 / 종단지연·정지드리프트·통신품질·결함주입 요약 CSV 4개
