Minssuung/BandLeadDevice/work_process/보고서자료_2026-06-12/MuJoCo_자기충돌.png

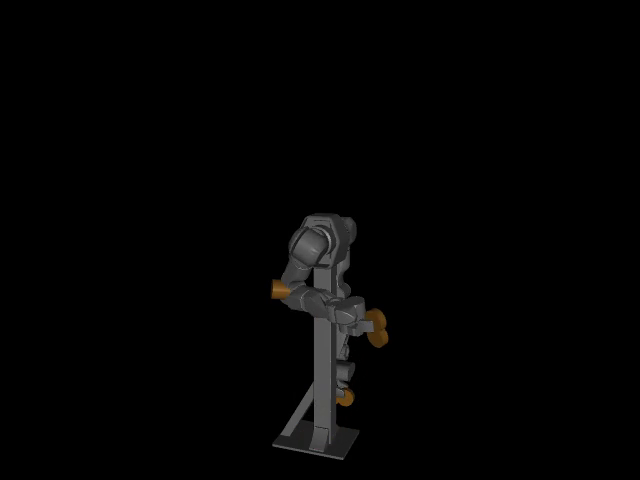
work_process/보고서자료_2026-06-12/MuJoCo_자기충돌.png
