Minssuung/BandLeadDevice/work_process/보고서자료_2026-06-12/시뮬텔레옵데모_프레임.png

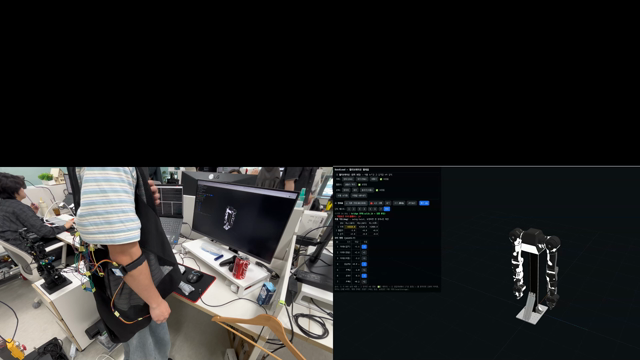
work_process/보고서자료_2026-06-12/시뮬텔레옵데모_프레임.png
