Minssuung/BandLeadDevice/print/trigger_lift_v3.stl

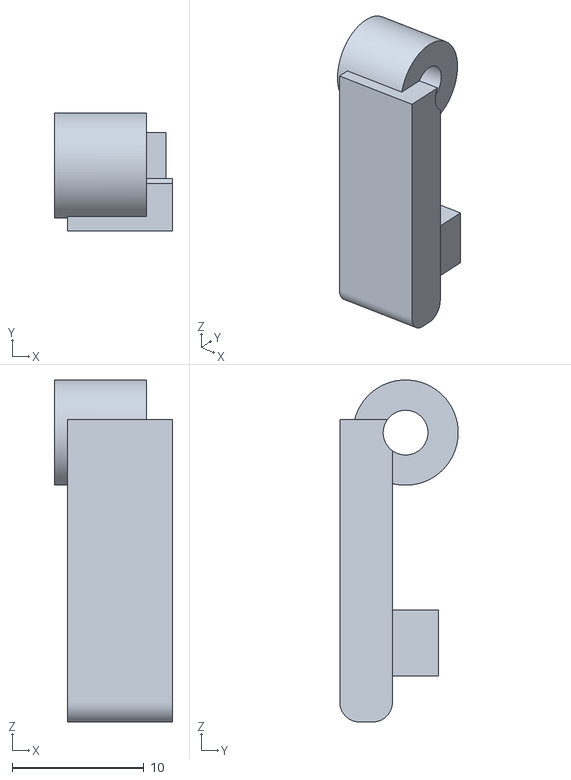
[picture p5: CAD file, 2026-06-24]
print/trigger_lift_v3.stl
9.00 x 9.00 x 26.0
