Minssuung/BandLeadDevice/viz/openarm_description/assets/end_effector/pinch_gripper/meshes/collision/finger_outer.stl

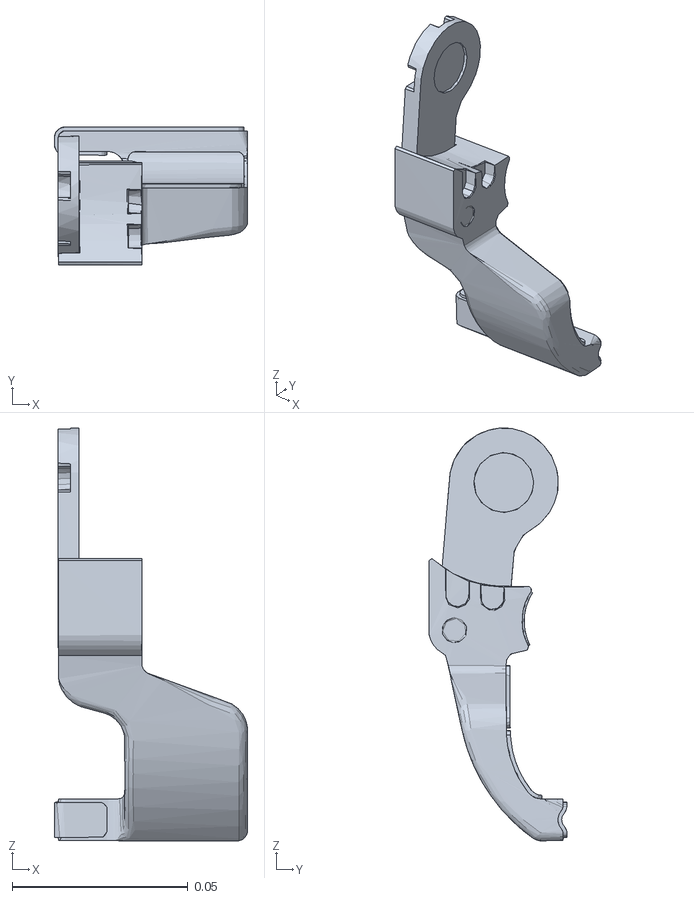
[picture p6: CAD file, 2026-06-21]
viz/openarm_description/assets/end_effector/pinch_gripper/meshes/collision/finger_outer.stl
0.055 x 0.0393 x 0.117
