Minssuung/BandLeadDevice/viz/openarm_description/assets/end_effector/pinch_gripper/meshes/collision/splited/finger_inner/finger_inner_01.stl

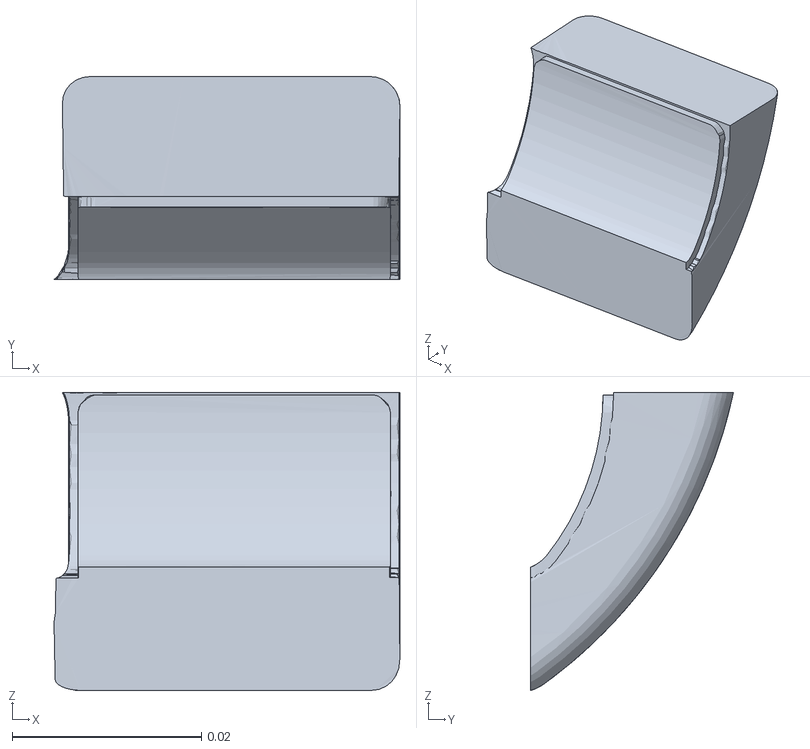
[picture p7: CAD file, 2026-06-21]
viz/openarm_description/assets/end_effector/pinch_gripper/meshes/collision/splited/finger_inner/finger_inner_01.stl
0.0365 x 0.0214 x 0.0315
