Minssuung/BandLeadDevice/viz/openarm_description/assets/end_effector/pinch_gripper/meshes/collision/splited/finger_outer/finger_outer_00.stl

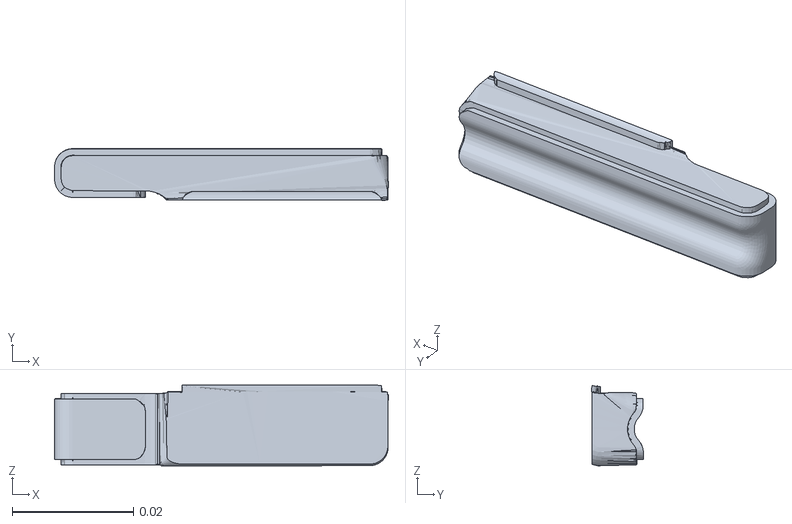
[picture p8: CAD file, 2026-06-21]
viz/openarm_description/assets/end_effector/pinch_gripper/meshes/collision/splited/finger_outer/finger_outer_00.stl
0.055 x 0.00854 x 0.0133
