Minssuung/BandLeadDevice/viz/openarm_description/assets/end_effector/pinch_gripper/meshes/collision/splited/finger_outter/finger_outter_00.stl

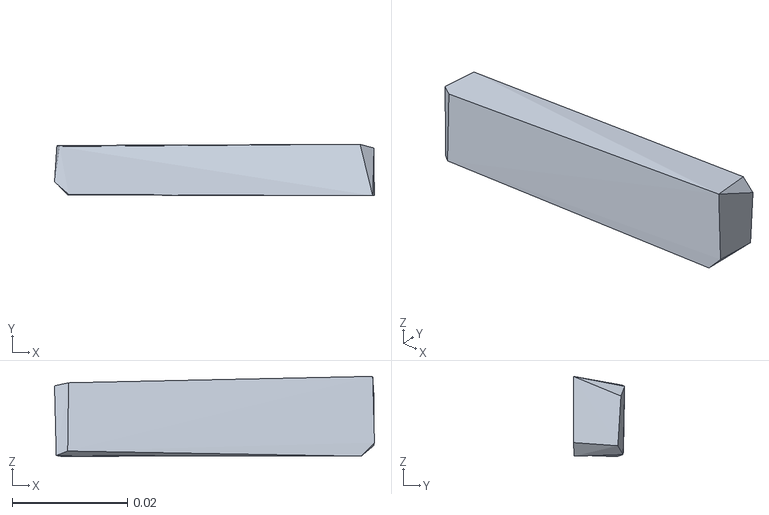
[picture p9: CAD file, 2026-06-21]
viz/openarm_description/assets/end_effector/pinch_gripper/meshes/collision/splited/finger_outter/finger_outter_00.stl
0.0554 x 0.00889 x 0.0139
