Minssuung/BandLeadDevice/viz/openarm_description/assets/robot/openarm_v2.0/meshes/arm/collision/link1.stl

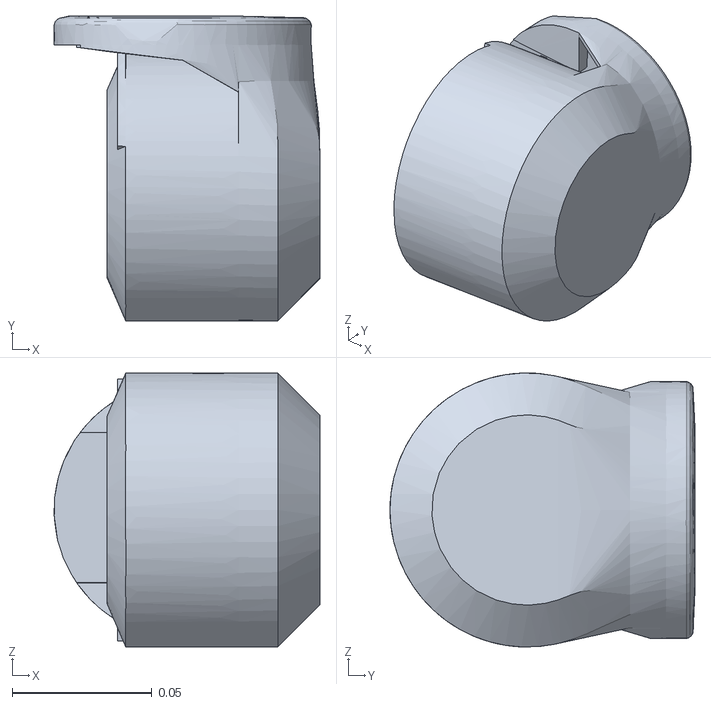
[picture p10: CAD file, 2026-06-21]
viz/openarm_description/assets/robot/openarm_v2.0/meshes/arm/collision/link1.stl
0.095 x 0.109 x 0.098
