Minssuung/BandLeadDevice/viz/openarm_description/assets/robot/openarm_v2.0/meshes/arm/collision/splited/link5/link5_00.stl

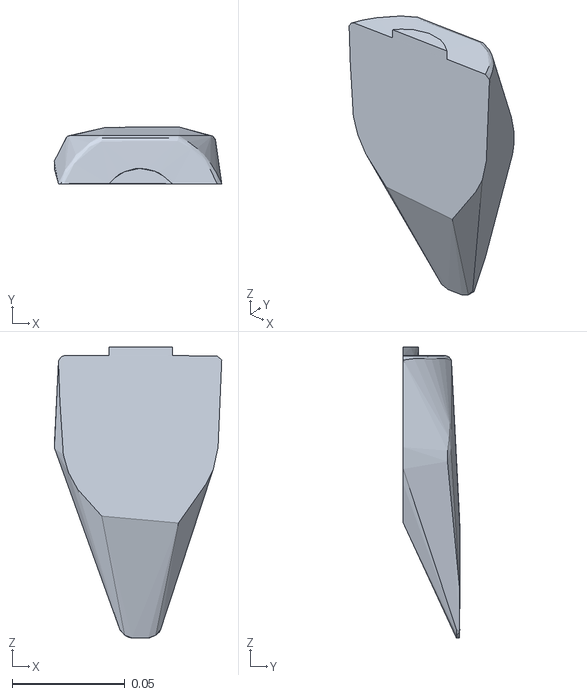
[picture p11: CAD file, 2026-06-21]
viz/openarm_description/assets/robot/openarm_v2.0/meshes/arm/collision/splited/link5/link5_00.stl
0.0741 x 0.025 x 0.129
