Minssuung/BandLeadDevice/viz/openarm_description/assets/robot/openarm_v2.0/meshes/body/collision/body_link0_symp.stl

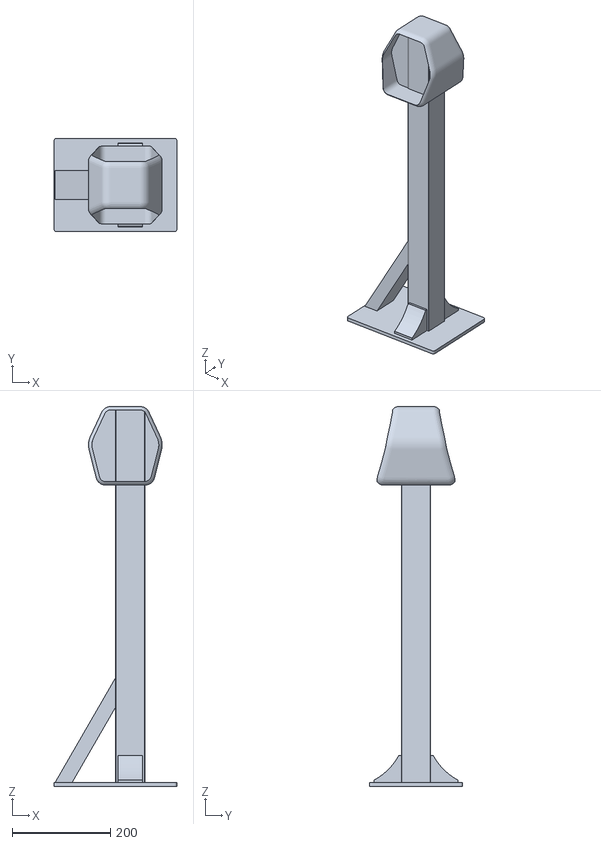
[picture p12: CAD file, 2026-06-21]
viz/openarm_description/assets/robot/openarm_v2.0/meshes/body/collision/body_link0_symp.stl
250.0 x 190.0 x 773.0
