Minssuung/BandLeadDevice/print/grip_right_v3.stl

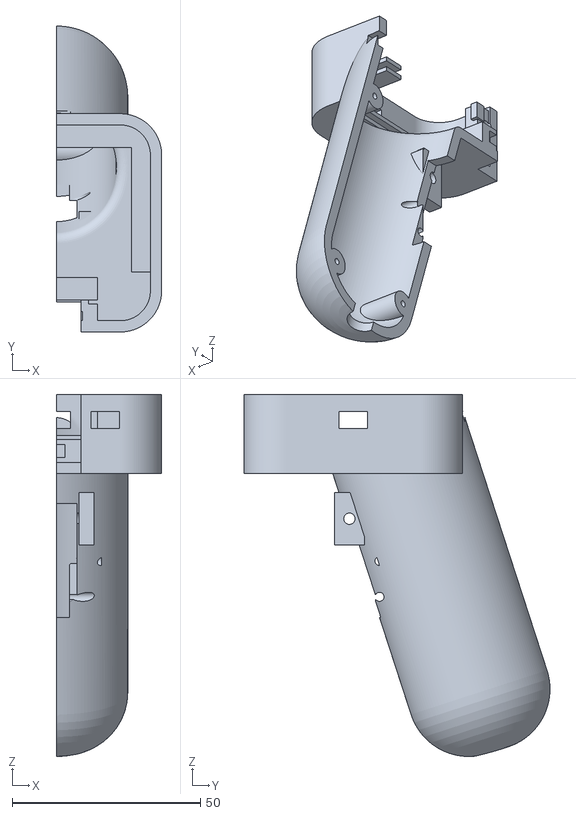
[picture p13: CAD file, 2026-06-24]
print/grip_right_v3.stl
28.0 x 81.3 x 96.2
