Minssuung/BandLeadDevice/viz/openarm_description/assets/end_effector/pinch_gripper/meshes/collision/splited/finger_inner/finger_inner_02.stl

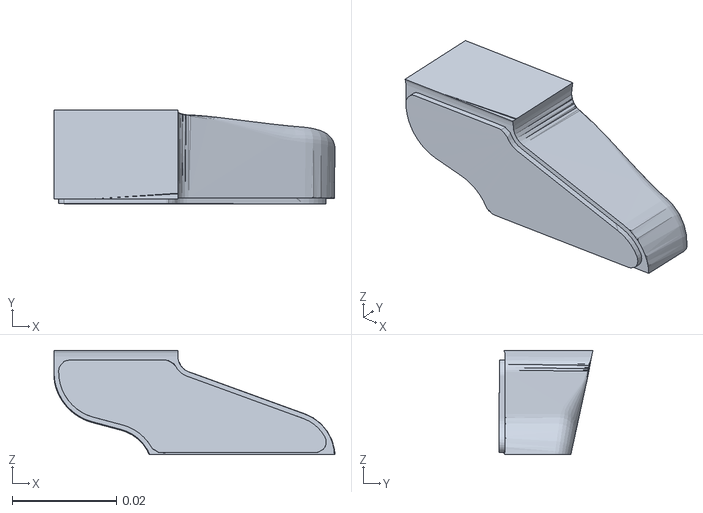
[picture p14: CAD file, 2026-06-21]
viz/openarm_description/assets/end_effector/pinch_gripper/meshes/collision/splited/finger_inner/finger_inner_02.stl
0.0538 x 0.018 x 0.02
