Minssuung/BandLeadDevice/viz/openarm_description/assets/robot/openarm_v2.0/meshes/arm/collision/link3.stl

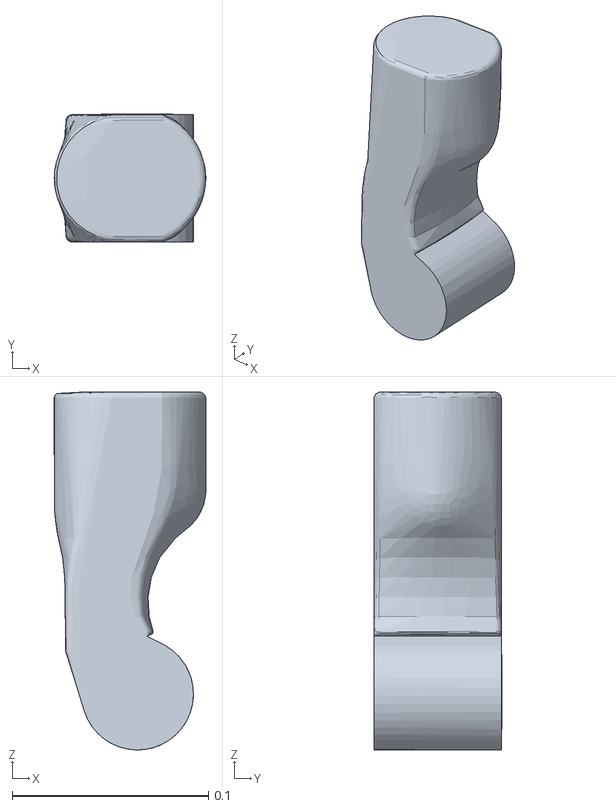
[picture p17: CAD file, 2026-06-21]
viz/openarm_description/assets/robot/openarm_v2.0/meshes/arm/collision/link3.stl
0.0773 x 0.0653 x 0.183
