Minssuung/BandLeadDevice/viz/openarm_description/assets/robot/openarm_v2.0/meshes/arm/collision/splited/link5/link5_02.stl

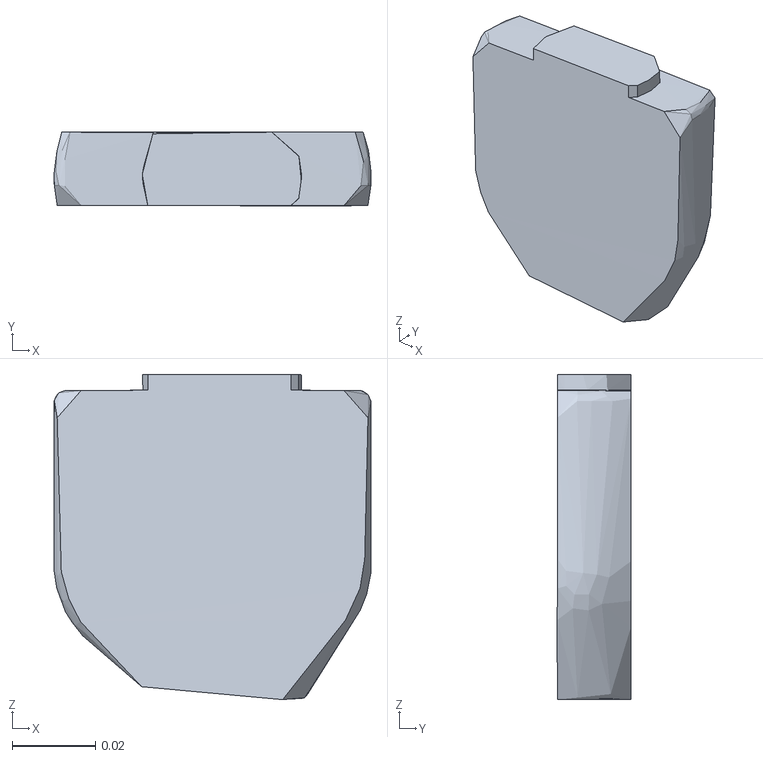
[picture p18: CAD file, 2026-06-21]
viz/openarm_description/assets/robot/openarm_v2.0/meshes/arm/collision/splited/link5/link5_02.stl
0.076 x 0.0177 x 0.078
