Minssuung/BandLeadDevice/viz/openarm_description/assets/end_effector/pinch_gripper/meshes/collision/ee_base_link.stl

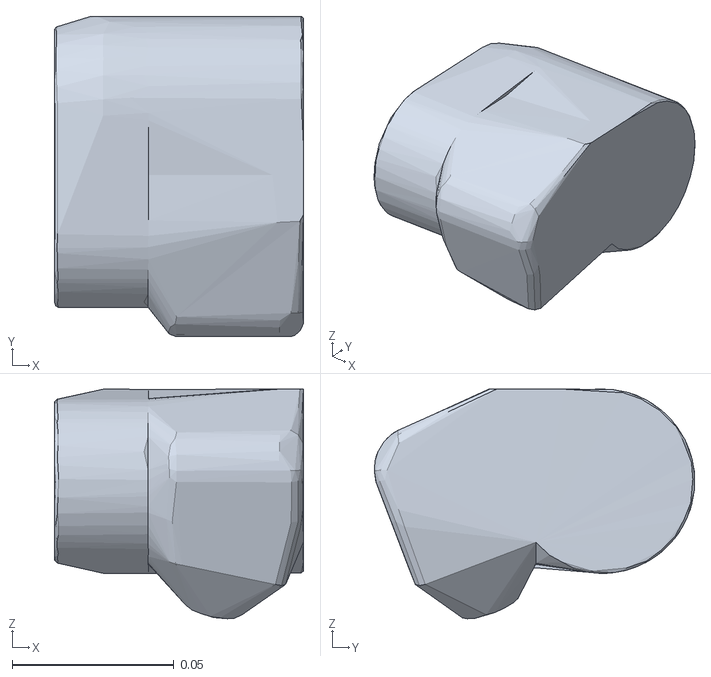
[picture p20: CAD file, 2026-06-21]
viz/openarm_description/assets/end_effector/pinch_gripper/meshes/collision/ee_base_link.stl
0.077 x 0.0991 x 0.071
