Minssuung/BandLeadDevice/viz/openarm_description/assets/robot/openarm_v2.0/meshes/arm/collision/base_link.stl

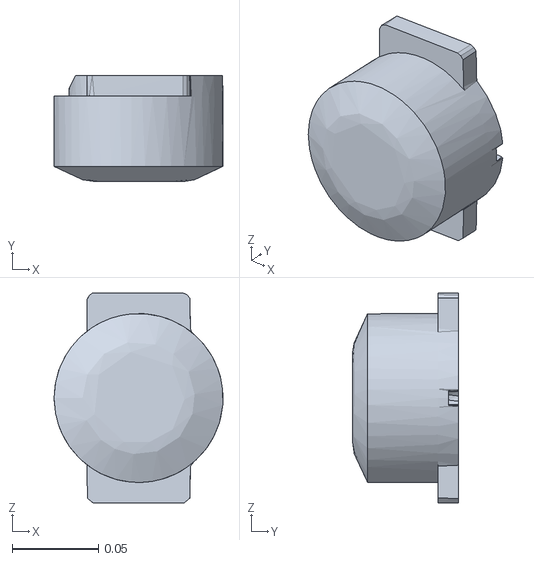
[picture p22: CAD file, 2026-06-21]
viz/openarm_description/assets/robot/openarm_v2.0/meshes/arm/collision/base_link.stl
0.0981 x 0.0615 x 0.122
