Minssuung/BandLeadDevice/print/grip_body_v3.stl

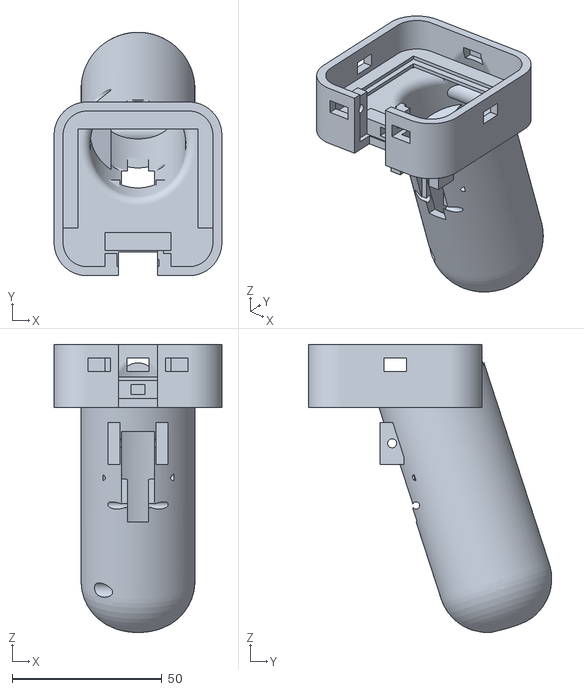
[picture p24: CAD file, 2026-06-24]
print/grip_body_v3.stl
56.0 x 81.3 x 96.2
