Minssuung/BandLeadDevice/print/carrier_v3.stl

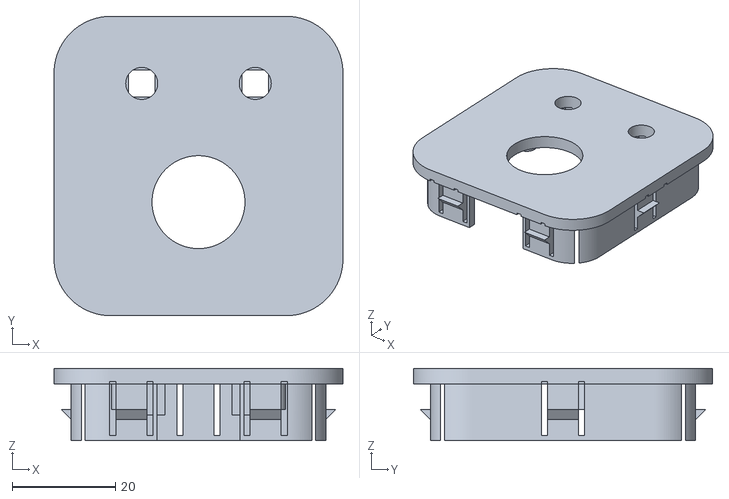
[picture p27: CAD file, 2026-06-23]
print/carrier_v3.stl
56.0 x 58.0 x 14.0
