Minssuung/BandLeadDevice/print/perfboard_v3.stl

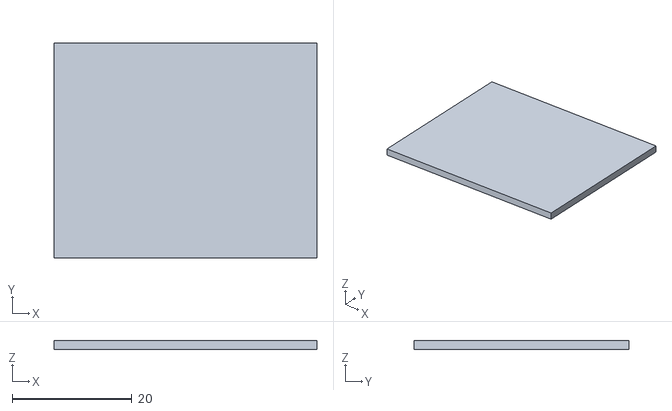
[picture p29: CAD file, 2026-06-23]
print/perfboard_v3.stl
44.0 x 36.0 x 1.50
