Minssuung/BandLeadDevice/print/trigger_lever_v3.stl

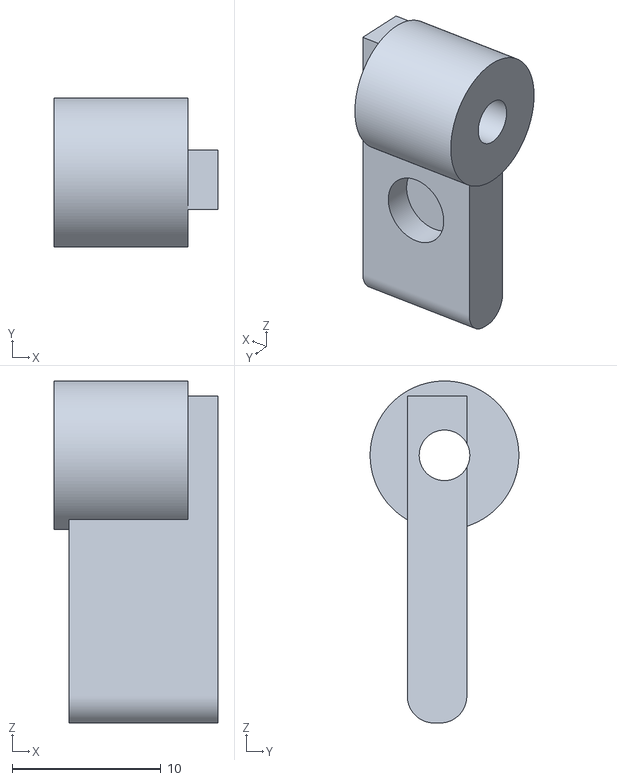
[picture p31: CAD file, 2026-06-23]
print/trigger_lever_v3.stl
11.0 x 10.0 x 23.0
