Minssuung/BandLeadDevice/print/button_caps_v3.stl

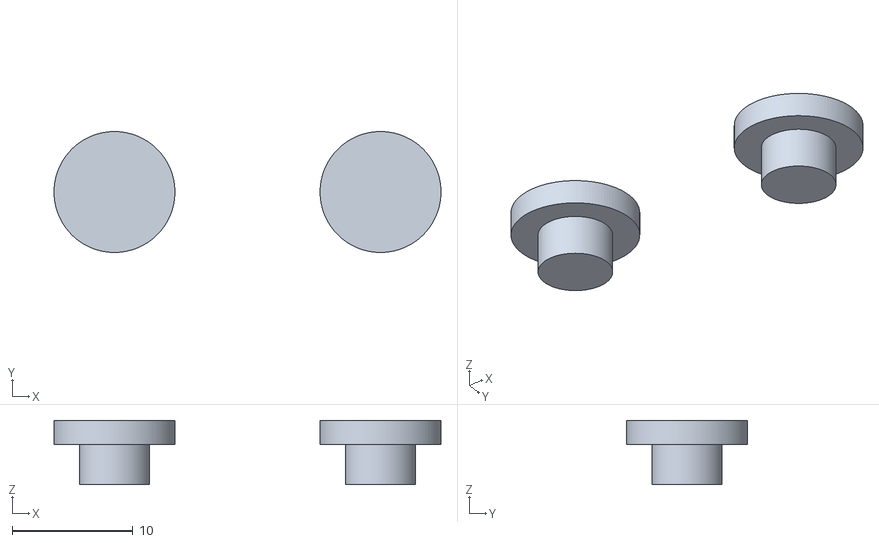
[picture p33: CAD file, 2026-06-23]
print/button_caps_v3.stl
32.0 x 10.00 x 5.30
