Minssuung/BandLeadDevice/(list of files, cad)

Other CAD files:
viz/openarm_description/assets/end_effector/pinch_gripper/meshes/collision/finger_inner.stl
viz/openarm_description/assets/end_effector/pinch_gripper/meshes/collision/splited/finger_inner/finger_inner_00.stl
viz/openarm_description/assets/end_effector/pinch_gripper/meshes/collision/splited/finger_outer/finger_outer_02.stl
viz/openarm_description/assets/end_effector/pinch_gripper/meshes/collision/splited/finger_inner/finger_inner_03.stl
