Minssuung/BandLeadDevice/print/PRINT_GUIDE.md

# Bandi V2 리드디바이스 — 프린트 & 조립 가이드 (턴키)

V3 파라메트릭 컨트롤러. **기능 검증 완료**(2라운드 독립 fact-check 통과 — 스냅 잠김·간섭·셸내부·watertight 전부 OK). 외형 미관 마감은 프린트 검증 후 별도(Blender 권장).

> ⚠️ 이건 **기능 프로토타입** 형상이라 약간 각져. 손에 쥐어 핏/작동 확인용. 매끈한 에르고 마감은 프린트로 기능 확정 후.

---

## 1. 출력물 (4개 + 만능보드는 직접 재단)

| 파일 | 크기 | 권장 출력방향 | 서포트 | 재료 |
|---|---|---|---|---|
| `grip_left_v3.stl` + `grip_right_v3.stl` | 각 ~28×81×96mm | **시임(평평한 안쪽면) 아래로** | 적음(평면 베드) | PETG 또는 PLA+ |
| (`grip_body_v3.stl` = 좌우 합친 참고용, 출력 X) | | | | |
| `carrier_v3.stl` | 56×58×14mm | **돔 아래로**(훅·스탠드오프 위로) + brim | 훅 약간 | **PETG**(훅 flex) |
| `button_caps_v3.stl` | 2개 | **디스크 아래로** | 거의 불필요 | PLA/PETG |
| `trigger_lift_v3.stl` | 1개(리프트 2단 트리거 레버) | 넓은 면 아래로(피벗보어 수평) | 약간 | PLA/PETG |
| `trigger_lever_v3.stl` | 12×10×23mm | 넓은 면 아래로(피벗보어 수평) | 약간 | PLA/PETG |
| `perfboard_v3.stl` | 44×36×1.5mm | (참고용 — 실제는 만능기판을 이 크기로 재단) | - | 만능기판(PCB) |

**만능보드 = 중앙 배선 허브**: 44×36mm로 재단(두께 1.5). **그립 하부 헤드(z-16) 트레이에 위에서 드롭인**(스커트·조이스틱 아래, 홀바 뒤). 모든 부품(조이스틱·홀·리프트·IMU/485·버튼) 선이 여기 모여 **바닥 케이블 1개로 컨트롤러 밖.** 부품 안 올라감(배선 그리드 + 케이블 단자만).
**공통**: 0.2mm 레이어(훅 0.15 권장), 외벽 3겹, 인필 20~30%, 노즐 0.4mm. 캔틸레버 훅 때문에 캐리어는 PETG 권장.

---

## 2. 조립 부품 (BOM)

| 부품 | 수량 | 들어가는 곳 |
|---|---|---|
| KY-023 조이스틱(모듈) | 1 | **캐리어 4 스탠드오프**(실측 29.1×23.4 M2, 90° 눕힘→펌웨어서 VRx/VRy 스왑), 스틱은 Ø18 돔홀로. 5핀 직배선 |
| 택트 스위치 6×6 | 2 | **캐리어 밑 택트 홀더**(토크오프·키보드) + 누름캡, 핀은 아래로 빠져 허브보드에 직배선 |
| **만능기판(PCB) 44×36×1.5 = 배선 허브** | 1 | **그립 하부 헤드 트레이**에 드롭인. 모든 선 모여 바닥 케이블로 |
| AH49E 홀센서 | 1 | 그립 앞 홀 마운트바 포켓(자석 마주봄). 3핀 직배선 |
| 네오디뮴 자석 Ø5×2mm | 1 | 트리거 레버 포켓 (홀이 읽음) |
| 피벗 핀 Φ3 (평행핀 또는 M3 볼트+너트) | 1 | 트리거 보스 2 관통 |
| 토션스프링 0.4선경×내경3.2 (또는 0.6×내경4) | **2** (검지+리프트) | Φ3 핀에 코일. **그립다리→그립 보스 관통홀, 레버다리→레버 관통홀**(둘 다 끼워 관통 후 끝 꺾어 걺). 다리 ~10mm 재단, 프리로드 손조정. 둘 다 트리거 복귀용 |
| **SS-5GL 리미트스위치** 19.8×6.4×10.2 (중지) | 1 | **손잡이 안 +X 마운팅보스에 2나사(Ø2.4 피치9.5) 셀프탭 고정**, 액추에이터 -Y(레버쪽). 중지 **2단 트리거 레버** 날 뒷면이 누름 — Meta Quest 그립버튼식. 2선 직배선 |
| 피벗 핀 Φ3 (리프트 2단 트리거) | 1 | 리프트 레버 피벗 보스 2 관통 |
| WT901C485 IMU(모듈) | 1 | 그립 -X벽 플레이트, **트리거 아래 전용구간**(손잡이 20mm 길어져 확보, z-75). M2 스탠드오프 2 (실측 대각홀 3/6.5 & 31/23.5). RS485 |
| MAX485 (모듈/IC) | 1 | **손잡이 IMU 옆**(+X쪽 cavity, 글루/타이). IMU RS485↔ESP32 UART |
| M2 셀프탭 나사 | ~8 | 조이스틱 4 · IMU 2 · **SS-5GL 2**(Ø2.4 셀프탭). 엄지택트·허브보드는 무나사(캡처/트레이) |
| M2×20 나사 (클램쉘 시임) | 4 | 좌우 반쪽 결합 — 왼쪽 옆면 접근홀로 넣어 오른쪽 보스에 셀프탭 |
| LOLIN D32 + 배터리 | — | **외부**(이 하우징 밖), 보드서 케이블로 연결 |
| 점퍼선(직배선) | — | 조이스틱5·홀3·리프트2·IMU(485) → 보드 junction → 외부 MCU(하단 Ø8). 커넥터 없음 |

---

## 3. 조립 순서 (PCB 중심)

**그립이 좌우 클램쉘** — 열린 반쪽에 부품 눕히고 닫아 나사. 조립 쉬움.
1. **각 반쪽에 부품** (열린 상태라 접근 쉬움)
   - **왼쪽**: IMU → -X벽 플레이트, MAX485 → 옆 / AH49E → 앞 홀포켓 / 트리거·리프트 보스(좌)
   - **오른쪽**: 트리거·리프트 보스(우)
   - **SS-5GL(중지 리미트) → 손잡이 안 +X보스에 2나사 셀프탭**(액추에이터 -Y=레버쪽). 2선 직배선
   - 검지·중지 트리거 레버: 양쪽보스 Φ3핀 + **토션스프링**(코일→핀, 다리 양끝 관통홀에 끼워 끝 꺾어 걺). 검지=자석 Ø5×2(홀센서가 읽음) / 중지=날 뒷면이 **SS-5GL 누름**(Meta Quest 그립버튼식)
2. **허브보드 + 배선** — 허브보드를 하부 헤드 트레이에 놓고, 모든 선(조이스틱5·홀3·리프트2·버튼·IMU→MAX485) 허브보드에 직배선 → **바닥 Ø8 출구로 외부 케이블 1개**
3. **좌우 반쪽 닫고 시임 나사 4개**(M2×20) — **왼쪽 옆면 접근홀로** 드라이버 넣어 조임(헤드뒤·정크션뒤·핸들하부 앞뒤)
4. **캐리어②에 조이스틱·버튼 장착**: KY-023 → 앞 4스탠드오프(29.1×23.4), 택트2 → 홀더에 밑서 삽입
5. **캐리어를 그립 헤드에 스냅** (5훅) → **버튼캡 2개** 끼움

---

## 4. 손가락 매핑 (작동)

- **엄지**: 조이스틱(주행) + A/B/menu 버튼캡(토크OFF·키보드 등)
- **검지**: 트리거(그리퍼) — 당기면 자석이 AH49E에 1~3mm로 접근해 아날로그 센싱
- **중지**: 앞면 2단 트리거 — 당기면 레버 날 뒷면이 **SS-5GL** 누름 + 토션스프링 복귀 (Meta Quest 그립버튼식)
- **내부**: IMU(손목/그립 자세, 18° 세로)

---

## 5. 핏 안 맞으면 (전부 파라메트릭, 즉시 재생성)

| 증상 | 조정 (`cad/parts.py` 또는 스크립트) |
|---|---|
| 스냅 헐렁/빡빡 | `SNAP_CLEAR`(0.15) / 훅 `LIP_OUT` |
| 부품 포켓 빡빡 | `FDM_CLEAR`(0.3) |
| 버튼캡 안 들어감(PLA 뻣뻣) | PETG로 출력 / 슬릿 폭↑ |
| 트리거 센싱 약함 | 자석-홀 갭(`HALL`/`MAG` 위치) |
| 트리거 끝에서 빡빡 | 14°에서 멈추거나 슬롯 모서리 더 깎기 |

재생성: `cad/.venv/bin/python cad/grip_body_v3.py && .../assemble_v3.py` → `cad/.venv/bin/python cad/audit_v3.py`로 자가검증.

---

## 6. 미관 마감 (프린트 검증 후)

기능이 실물로 확정되면 **Blender**로 grip_body 외형만 Smooth/Sculpt (내부 정밀 유지).

**미관 타깃 = 실제 Meta Quest 3 컨트롤러 스캔** (`cad/ref/quest3_full_right.stl` = 완전체, `cad/ref/quest3_cover_right.stl` = 손잡이 겉쉘). 곡선 에르고 손잡이 + 라운드 헤드 + 유기적 블렌딩.

**Blender 워크플로**:
1. 우리 `grip_body_v3.stl`(또는 좌우 합본)을 Quest 스캔과 정렬(헤드·손잡이축 맞춤)
2. 겉면을 Quest 스캔 형상에 맞춰 조각(Shrinkwrap/Sculpt) — **내부 마운트·포켓·홀은 유지**
3. ⚠️ **손잡이 단면은 우리 치수 유지**: IMU(폭30)+보드 때문에 Φ38 필요 → Quest(단면 27×28)보다 두꺼움. **스타일(곡률·라운드)만 맞추고 굵기는 우리 것**

> cadquery 파라메트릭으론 박스-원통 경계 블렌딩이 안 됨(fillet·loft 실패 확인) → 이 단계는 메시 기반(Blender)이 정석.
