Minssuung/BandLeadDevice/work_process/1_IMU_sensor_test/README.md

### venv 환경에서 requirements 설치
```pip install -r requirements.txt```

### permission denied 발생시
```sudo usermod -aG dialout $USER```
이후 재부팅

### buad rate 맞추기
baud 를 115200로 맞춰야 작동
