Minssuung/BandLeadDevice/(commit log)

2026-06-21 초기 커밋: BandLeadDevice (밴드형 리드디바이스 텔레옵)
    IMU x3 -> ESP32 -> Wi-Fi UDP -> DYNAMIXEL 7축 텔레옵. swing-twist 분해, 캘리브레이션, viz, sim_mujoco, 개발로그.
    [20260612_152221_S1_track_j1.csv, 20260612_152250_S1_track_j1.csv, 20260612_152333_S1_track_j1.csv, 20260612_152431_S1_track_j1.csv, 20260612_161202_HM_human.csv, 20260612_162311_HM_human.csv, 20260612_180333_HM_human.csv, 20260615_095939_HM_human.csv]
2026-06-21 docs: README 작성 (개요·데이터흐름·실행·검증성과·안전)
2026-06-21 cad: V2 컨트롤러 설계 파이프라인 (그립 재구성 + 헤드캐리어 v1)
    - parts.py: 부품 실측 스펙(IMU/KY-023/택트/트리거/리프트)
    - step_inspect·render·dering·rebuild·poisson: 원본 Quest STEP 분석 + 링제거 + watertight 재구성(메시)
    - carrier.py: 헤드캐리어 v1 (KY-023 돔홀/마운트 + 택트 포켓3, 캐비티 맞춤)
    - 그립=실형상 메시, 정밀부품=파라메트릭 cadquery
2026-06-22 cad: 그립 솔리드 watertight 확정 (poisson2)
    - Poisson(닫힌면) → pymeshfix(watertight manifold 복구) → manifold boolean-crop
    - 구멍/링잔여 제거, 실제 Quest 형상 보존, bbox 51x112x64, watertight True
    - 의존성: open3d/trimesh/manifold3d/networkx/pymeshfix (cad/.venv)
2026-06-22 cad: 링 제거 자리 캡핑 (cap_ring.py)
    - 복셀 채움 + morphological closing(R=8mm) → 링 넥 함몰을 벽으로 메움
    - grip_capped.stl = 링 메운 watertight 그립 본체
2026-06-22 cad: 트리거 모듈 v1 + 그립 스무딩
    - trigger.py: 레버(피벗Φ3·자석Φ5x2 포켓·스프링레그) + 홀마운트(AH49E·M2x2)
    - cap_ring.py: pitch/스무딩 인자화, pitch 0.6+taubin 25로 뭉퉁함 개선
    - 3개 파트 v1 완료: 그립본체/헤드캐리어/트리거모듈
2026-06-22 cad: 그립 shell + 헤드 개구부 (grip_shell.py)
    - 복셀 erosion으로 속비움(wall 3mm, cavity 69%) → watertight shell
    - 헤드 footprint(z=-4 단면 hull, 레지 4mm 인셋) 위쪽 개구 = 캐리어 드롭인 구멍
    - 스냅핏 조립의 호스트 그립
2026-06-22 cad: 스냅핏 조립 v1 — 캐리어↔그립 (assembly.py)
    - 캐리어 v2: 플랜지(림 안착)+스커트(드롭인)+캔틸레버 훅4 + 버튼/스틱 컷
    - 그립 림에 창4 boolean → 훅 걸림. grip_assembled.stl / carrier_v2.stl
    - 배터리커버식 스냅(FDM 견고)
2026-06-22 cad: 클램셸 스냅 조립 — 잠김 검증 통과 (clamshell.py)
    - PART_Z=-2 상/하 분할: 캐리어②=실제 돔 윗면캡+버튼홀+캔틸레버 립훅 / 그립①=몸통 shell+창
    - 잠김 retention=True 수치검증(창 위 그립벽이 립 캐치를 막음)
    - 버그수정: 훅을 Pz(외곽) 대신 립벽 외곽선에 배치(립이 그립벽 창으로 박히게)
    - analyze_grip/verify_hook: 방향·버튼면(z≈+2 윗면)·잠김 분석 도구
    - 두 파트 watertight, shape 보존
2026-06-22 cad: V3 파라메트릭 재설계 — 형상 + 엄지 입력부 (Stage1~2a)
    - controller_v3.py: 깨끗한 피스톨그립 형상(헤드+기울인 손잡이), 입력 배치
    - head_carrier_v3.py: 조이스틱 마운트(돔홀+4보스) + A/B/menu 버튼캡 눌림 메커니즘
    (디스크 돌출 0.8 스트로크 + 스템 택트작동 + 리테이너 플랜지 빠짐방지)
    - 내부 부품: IMU만(MCU·배터리 제외)
    - 디자인 방향: 기능먼저→미관 마지막 패스
2026-06-22 cad: V3 Stage2b 검지 트리거 메커니즘 (trigger_v3.py)
    - 레버 Φ3 피벗 회전 + 자석Φ5x2 포켓 + AH49E 홀 마운트
    - 당김 16° → 자석-홀 갭 3.0→2.0mm (아날로그 그리퍼 센싱)
    - 피벗 보스2 + 핀 + 홀 포켓, rest↔pull 동작 검증 렌더
2026-06-22 cad: V3 Stage2c 측면 리프트 + IMU 크래들 (lift_imu_v3.py)
    - 리프트 SS-5GL: 본체 손잡이 내부, 레버만 측면(+X) 돌출(중지)
    - IMU 34x30x10: 11mm 슬롯 30° 세로 크래들(손잡이 하부)
    - 모든 입력 메커니즘 설계 완료(엄지스틱·A/B/menu·검지트리거·중지리프트·IMU)
2026-06-22 cad: IMU 세로 방향 수정 + 전체 조립본/점검 도구
    - lift_imu_v3: IMU 넓은면을 측면(±X)으로 회전 → 얇은 날처럼 세로(슬롯 X방향)
    - combine_v3.py: 모든 V3 파트 합본 assembly_v3.stl/png
    - imu_orient.py: IMU 방향 라벨 점검
2026-06-22 cad: IMU 수납 수정 — 18° 세움 + 손잡이 Ø34→38
    - IMU 18°로 세워 손잡이 축과 정렬(30°→18°), 손잡이 중심선 위 배치
    - 손잡이 Ø34→38: 30mm폭 IMU 보드가 셸 캐비티(벽3)에 수납되게
    - 더이상 몸통 밖으로 안 삐져나옴
2026-06-22 cad: IMU 마운트 정정 — 대각 M2 스탠드오프 2개 (보드 실측 홀)
    - parts.py: IMU_MOUNT_HOLES [(3,6.5),(31,23.5)] Ø2, slot 폐기, tilt 18
    - lift_imu_v3: 슬롯 크래들 → 보드 대각 Ø2 홀에 M2 스탠드오프 보스 2개
    - 보드 34×30×10 치수 라벨 렌더, combine 업데이트
2026-06-22 cad: V3 Stage2d-1 그립 본체 통합 (grip_body_v3.py)
    - 형상 → shell(벽3, 상단개구) 속 비움
    - 통합: 트리거 피벗보스2+홀포켓 / 리프트 SS-5GL 포켓+레버창 / IMU 대각 스탠드오프2
    - 헤드 상단 개구 = 캐리어 자리
2026-06-22 cad: V3 Stage2d 3파트 통합 조립 — 스냅 잠김 검증 (assemble_v3.py)
    - 헤드 캐리어②: 플랜지+스커트+캔틸레버 훅4 + 조이스틱돔/보스 + 버튼홀
    - 그립 헤드벽에 창4 → 캐리어 스냅, retention=True 검증
    - 그립①+캐리어②+트리거③ 조립 렌더(+분해뷰)
    - 깨끗한 박스 헤드라 스냅 안정적
2026-06-22 cad: 조립 완성 — 6개 갭 닫고 종합검증 통과 (install-ready)
    - 버튼캡(택트홀더+누름캡+리테이너) 통합, 트리거 레버통로 슬롯+스프링앵커
    - 리프트 SS-5GL 고정보스, 배선출구 Ø8(손잡이바닥), 조이스틱 보스깊이 보정
    - 종합검증: 잠김True / 캐리어28·조이18·트리거40mm³ 간섭 / 조립가능 OK
2026-06-22 cad: 떠있는 내부조각 제거 — 모든 마운트 셸에 부착 (검증)
    - IMU: 백킹플레이트 intersect(손잡이)로 -X벽 부착
    - 리프트: 벽부착 브래킷 → 포켓/레버창/나사홀
    - 트리거 보스: 앞벽 부착 블록 + 핀홀, 스프링 포스트 벽부착
    - grip_body 연결조각 3→1 (떠있는 조각 0), 종합검증 OK 유지
2026-06-23 cad: fact-check 블로커 6개 수정 + 자가감사 (audit_v3.py)
    - B1 자석포켓 방향수정(실제 포켓 생성) B2 리프트 +X벽으로(x12.75) B3 배선 동축관통
    - B4 버튼캡 압축슬릿 H1 슬롯+Y확장(트리거16° 101→57) H2 트리거 릴리프+−Y훅제거(레버간섭 0)
    - M1 홀 마운트바(보스 연결) 피벗 -9로 낮춤
    - audit_v3.py: 연결성·watertight·전구간스윙·셸내부 contains·간섭 자가검증 → 전부 통과
2026-06-23 cad: 2차 fact-check 수정 — B2/B3/H1/NEW-1 + 자가감사 전통과
    - B2 리프트 x11.5(+X벽 2mm, 창 양옆 하우징) B3 배선 실제 손잡이축으로 바닥(0,35,-96.5) 관통
    - H1 홀바 뒤로(-20.5, overshoot/충돌 제거, 갭 3.0→1) 트리거16° 잔여 47mm³
    - NEW-1 앞훅2 복원(트리거슬롯 양옆 x±13) — 캐리어 앞 잠김
    - audit_v3: 앞훅 캐치·리프트 하우징 체크 추가 → 전부 통과
2026-06-23 cad: M2 버튼 림 확보 — 버튼 재배치(구멍이 플랜지 모서리 안, 림 2mm)
    - B(0,27→0,23) 등 재배치, 스틱 뒤·플랜지 내. fact-check 최종: print/assemble-ready
    - 블로커 B1~B4+H2+M1+앞훅 전부 독립확인 수정, 회귀 없음
2026-06-23 cad: 미관 탐색 — 메시 스무딩으로 에르고 형상 시연 (smooth_form.py)
    - cadquery fillet/loft는 box-cylinder-tilt 경계 블렌딩 실패(BRep) 확인
    - 메시 모폴로지(closing+opening+Taubin)로 매끈 에르고 형상 시각화(controller_smooth)
    - 기능 파트는 정밀 유지(스냅/포켓) — 매끈함과 충돌, 별도 마감 필요
2026-06-23 print: 턴키 프린트 패키지 — STL4 + 조립가이드/BOM
    - print/: grip_body·carrier·button_caps·trigger_lever STL + PRINT_GUIDE.md
    - 출력방향·서포트·재료, 조립순서, 부품 BOM, 핏 조정표, 손가락매핑
    - 기능 검증완료(2라운드 fact-check), 미관은 프린트후 Blender
    [button_caps_v3.stl, carrier_v3.stl, grip_body_v3.stl, trigger_lever_v3.stl]
2026-06-23 cad: 트리거 피벗 핀홀 복구 (union이 메우던 버그)
    - 피벗 보어 Φ3.4를 hub.union(arm) 후에 cut → arm이 안 메움
    - 검증: 핀홀축 전구간 관통(contains False), 허브 솔리드 유지, 자석포켓 OK
    - print/trigger_lever_v3.stl 갱신, trigger_explain.py 추가(핑거패드/홀 라벨)
    [trigger_lever_v3.stl]
2026-06-23 cad: 부품하우징 버그 2개 수정 (cut-후-union/방향 클래스)
    - BL-1 버튼B 메움: 버튼 3개를 스틱 뒤 한 줄(y14)로 이동 → 모든 훅서 이격(메움 방지)
    - BL-2 조이스틱 보스 파일럿: cutBlind(6)→(-6) 방향수정 → 4개 다 관통
    - audit_v3: 조이스틱 파일럿·버튼B 구멍/포켓 체크 추가 → 전부 통과
    - print/ carrier·caps STL 갱신. 트리거보어/자석/홀/리프트/IMU/배선/캡슬릿 clean 재확인
    [button_caps_v3.stl, carrier_v3.stl]
2026-06-23 cad: PCB(만능보드) 중심 재설계 — 부품을 보드에 실장
    - 만능보드 40x44x1.5(perfboard_v3): 조이스틱+택트3 실장, 앞중앙 노치(트리거 회피)
    - 캐리어 단순화: 택트홀더·조이스틱보스 제거 → 돔홀+버튼홀+캡+스냅+PCB 스탠드오프4
    - 캡 단순화: 디스크+스템(아래 택트가 받쳐 빠짐방지 — 플랜지/슬릿 불필요)
    - 홀/리프트/IMU는 직배선으로 보드 연결, 보드↔외부 MCU 케이블
    - audit: 보드↔그립 6mm³ 수납·스탠드오프·스틱컷·노치 검증 → 전부 통과
    - PRINT_GUIDE PCB 조립순서/BOM 갱신
    [button_caps_v3.stl, carrier_v3.stl, perfboard_v3.stl]
2026-06-23 cad: 설명용 렌더 추가 (full_v3·lift_explain·carrier_explain)
    - full_v3.py: 전체 조립 한 컷, carrier_explain: 캐리어 구멍 라벨(돔/버튼/PCB스탠드오프)
    - lift_explain: SS-5GL 포켓/나사홀/레버창 확인
2026-06-23 cad: PCB 스탠드오프가 버튼홀 침범하던 버그 수정
    - 스탠드오프 (±18,±16/-18) → (±18,±6/-8) 옆쪽 이동 (조이스틱±13·버튼y14 사이)
    - 버튼홀 Ø8 가장자리 더이상 안 막힘 (audit 버튼홀 가장자리 체크 추가, 통과)
    - 보드 마운트홀도 동일 이동, print/ 갱신
    [carrier_v3.stl, perfboard_v3.stl]
2026-06-23 cad: 만능보드 좌표 버그(BL-1) 수정 — 모든 구멍 절대좌표
    - perfboard: faces(>Z).workplane().moveTo()가 보드중심(0,-2) 기준이라 전 구멍 Y-2mm 밀림
    → 월드 절대좌표 cut으로 변경. 스탠드오프홀/조이스틱/택트가 캐리어와 정렬
    - 앞 노치 x±10→±12: 트리거보스 스침 제거(보드↔그립 5.6→1mm³)
    - audit: 택트/스틱 y정렬 체크 추가 → 전부 통과
    [perfboard_v3.stl]
2026-06-23 cad: perfboard watertight 수정(H-1) — 노치 non-manifold pymeshfix 정리
    - 종합검증: 6개 부품하우징 PASS, 4개 버그클래스 clean, 5훅 잠김, 충돌없음
    - perfboard 비-watertight(노치코너 엣지1) → pymeshfix로 watertight 보장
    - 전 STL watertight+연결성 정상. 비블로커: M-1(조이스틱깊이 실물확인) M-2(트리거끝당김) M-3(캡리테이션)
    [perfboard_v3.stl]
2026-06-23 cad: 버튼2 + 조이스틱 모듈 하우징 분리 + 보드=택트2/junction
    - KY-023은 모듈 → 만능보드에서 분리. 캐리어에 자체 4 스탠드오프(27x20), 5핀 직배선
    - 버튼 3→2 (토크오프·키보드). 캡 2개
    - 만능보드 40x44→40x18: 택트2 + 배선 junction 전용(조이스틱 뒤). 조이스틱홀/노치 제거
    - MAX485는 손잡이 IMU 옆 cavity(공간 확인됨), 보드 안올림
    - audit/가이드/BOM/렌더 갱신 → 전부 통과
    [button_caps_v3.stl, carrier_v3.stl, perfboard_v3.stl]
2026-06-23 cad: 조이스틱 모듈이 트리거 허브와 충돌(91mm3) → JOY y-9→-6 이동
    - 레버 뒤끝 y-20, 모듈(26깊이) 앞끝이 거기 침범 → 조이스틱 3mm 뒤로
    - 모듈↔트리거 91→0mm3, 모듈↔그립 0. audit에 조이스틱모듈 envelope 검사 추가
    - 돔/스탠드오프 위치 갱신, 전부 통과
    [carrier_v3.stl]
2026-06-23 cad: 트리거 토션스프링 마운트(0.4선경xID3.2 일자) 추가
    - 레버 허브 +X 축소(extrude12→9) → 보스와 틈 x5~7 확보(코일 ID3.2/OD4 자리)
    - 그립 다리 포스트 +X보스 위(x7.5)에 — 슬롯·레버·조이스틱 다 회피(이전 포스트는 슬롯에 잘려나감)
    - Φ3 핀 유지(ID3.2 딱맞음). 다리 20mm는 재단·프리로드 손조정
    - audit: 코일틈·포스트·모듈↔트리거0 검사 추가, 전부 통과
    - trigger_spring_explain 렌더 + 가이드/BOM 갱신
    [grip_body_v3.stl, trigger_lever_v3.stl]
2026-06-23 cad: 버튼 구멍 Ø8→Ø6.2 (스템 가이드, 헐렁함 수정) + 보드 택트 표면실장
    - 버튼홀 Ø8은 스템 Ø5.8이 2mm 헐렁 → Ø6.2 가이드로(꽉맞음, 안흔들림)
    - 만능보드 5×5 택트컷 제거 → 택트는 표면 납땜, 핀홀 Ø1만(올바른 만능기판 실장)
    - button_explain 단면 렌더 추가(캐리어홀+캡+택트+보드 적층)
    - audit: 택트 자리 보드 솔리드 검사로 갱신, 전부 통과
    [carrier_v3.stl, perfboard_v3.stl]
2026-06-23 cad: 실측 부품치수 반영 — KY-023 마운트 29.1x23.4, SS-5GL 나사 피치6.4 Ø2.3
    - JOY_MOUNT_GRID 27x20(추정,틀림)→실측 29.1x23.4(90도 눕힘, 펌웨어 VRx/VRy 스왑)
    - 큰 조이스틱 맞춰 JOY y-6→-7, 보드 y15→16, 스탠드오프 뒤로(10/22)
    - 리프트 나사홀 12mm/Ø1.8(임의)→실측 피치6.4/Ø2.3
    - IMU 대각홀은 사용자 실측값 그대로 유지(내가 추정이라 한 거 정정)
    - audit 모듈 envelope/스탠드오프 위치 갱신 → 전부 통과
    [carrier_v3.stl, grip_body_v3.stl, perfboard_v3.stl]
2026-06-23 cad: 만능보드 마운트 = 드롭인 스냅레일(무타공) — 닫힌 스커트라 슬라이드 불가
    - 만능기판은 납땜 그리드뿐 → 무타공 요구. 슬라이드는 닫힌 스냅스커트가 막아
    - 드롭인 스냅: 보드를 아래(cavity)서 끼워올림, 얇은 flex 바깥벽+아래캐치(0.3물림)+위스톱립
    - 보드 40x18→40x16 단축(뒷 스커트 회피, 캐리어↔보드 73→0mm³)
    - 앞스톱 z-3까지 올려 플랜지에 연결(떠있는 조각 수정), 조이스틱 스탠드오프(±14.55) 피함
    - 가이드/BOM 드롭인+실측치수로 갱신, audit 전통과
    [carrier_v3.stl, perfboard_v3.stl]
2026-06-23 재설계: 만능보드 = 중앙 배선 허브(그립 하부 드롭인), 버튼은 캐리어 홀더로
    - 허브보드 44x36 그립 하부 헤드(z-16) 트레이에 드롭인 — 모든 부품선 모여 바닥 케이블 1개로
    (스커트-14·조이스틱-13 아래, 홀바 뒤. 허브보드↔그립 0mm³, 모듈↔보드 0)
    - 버튼: 보드서 떼고 캐리어 밑 택트홀더+캡(핀 아래로 허브 직배선)
    - 캐리어 보드레일 제거, 조이스틱 스탠드오프 유지
    - audit 트레이/홀더 검사로 갱신, 가이드 허브구조로 재작성 → 전부 통과
    [carrier_v3.stl, grip_body_v3.stl, perfboard_v3.stl]
2026-06-23 수정: SS-5GL 배선슬롯 + 허브보드 흔들림방지 위립 + 버튼 리테이너
    - SS-5GL 포켓에 배선 슬롯 추가(포켓 -X→cavity, 단자 2선이 위 허브보드로). 브래킷/나사 유지
    - 허브보드 트레이에 위립 추가(받침+위립 Z샌드위치) → 흔들림 방지. 보드↔그립 0
    - 버튼 택트: 포켓 6.6→6.3 스너그 + 바닥 리테이너 링 → 누를때 안빠짐(body가 플랜지-링 사이 갇힘)
    - audit 슬롯/위립 검사 추가, 브래킷 검사점 슬롯밖으로 → 전부 통과
    [carrier_v3.stl, grip_body_v3.stl]
2026-06-23 cad: 리프트 브래킷 +X벽쪽 축소 → IMU 보드(-X) 자리 확보
    - 리프트 브래킷 x-2.5..21.5 → x5..(벽). IMU보드(x≤1)와 충돌 562→187mm³
    - 나사깊이 5→3, 배선슬롯 축소. audit 브래킷 검사점 갱신 → 전부 통과
    - 남은 이슈: IMU 핸들 삽입 빡빡(~1000mm³ 스침), 보드/IMU 닫힌그립 조립난이도 → 모듈화 검토 필요
    [grip_body_v3.stl]
2026-06-23 재설계: 그립 좌우 클램쉘(2쪽) — 조립식
    - 그립을 x=0 시임서 좌/우 분리: 왼쪽=IMU측, 오른쪽=리프트 SS-5GL측
    → 열린 반쪽에 부품 눕히고 닫음(IMU·허브보드·배선 다 접근). 깊은부품 삽입난이도 해결
    - 시임 나사보스 3(헤드뒤·핸들2), 우=파일럿/좌=클리어. 양쪽 watertight·1조각
    - grip_body_v3.stl=조립체(검증/렌더 유지), grip_left/right=출력용
    - clamshell_v3 렌더, 가이드 클램쉘 조립으로 갱신, audit 통과
    [grip_left_v3.stl, grip_right_v3.stl]
2026-06-23 cad: 클램쉘 나사보스 앞뒤 분산 + 떠있는 조각 수정
    - 보스 한쪽(뒤)만 → 앞뒤 균등: 헤드뒤·정크션뒤·핸들하부 앞+뒤 4개
    - 정크션 앞보스는 벽 얇아 floating → 제거(거긴 트리거핀이 양쪽보스 관통해 체결)
    - IMU구간(z-34..-76) 보스 회피(보드가 시임 가로지름)
    - 셀프탭(우=파일럿Ø1.7 M2셀프탭 / 좌=클리어Ø2.6). 양쪽 watertight·1조각, audit 통과
    [grip_body_v3.stl, grip_left_v3.stl, grip_right_v3.stl]
2026-06-23 cad: 클램쉘 나사 제대로(접근홀+내부보스) + SS-5GL 핑거패들
    - 나사보스: 옆면서 드라이버 넣는 접근홀 Ø2.8 관통(전엔 구멍없어 못넣음) + 보스 안쪽배치(바깥 안튀어나옴)
    우=파일럿Ø1.7 셀프탭/좌=클리어. 4개 접근홀 다 외부로 뚫림, 양쪽 watertight·1조각
    - SS-5GL 핑거패들(lift_pad): 금속레버 끝에 끼워 중지가 넓게 누름
    - audit 통과
    [grip_body_v3.stl, grip_left_v3.stl, grip_right_v3.stl, lift_pad_v3.stl]
2026-06-23 docs: 가이드 클램쉘 나사(4x M2x20 옆면 접근홀)+SS-5GL 핑거패들 반영
2026-06-23 수정: 클램쉘 보스 떠있음 해결 + 택트 리테이너 강화
    - 보스가 시임벽에 안붙어 떠있던 것(0.4~0.6mm) → 벽에 1.7mm 물리게 재배치
    헤드보스 제거(z-10 시임은 거의 cavity, 헤드는 캐리어가 체결). 정크션뒤+핸들하부 앞뒤 3개, 다 벽 연결
    - 택트 리테이너 링 캐치 0.2→0.4mm: 택트가 플랜지(위)+링(아래) 사이 갇힘 → 눌러도 안빠짐
    - button_explain 단면 갱신(택트 고정 방식), 양쪽 watertight·1조각, audit 통과
    [carrier_v3.stl, grip_body_v3.stl, grip_left_v3.stl, grip_right_v3.stl]
2026-06-24 재설계: 클램쉘 나사=솔리드 다리(노출X) + SS-5GL 포켓 시임쪽 열림(삽입가능)
    - 나사경로가 cavity 가로질러 노출되던 것 → 벽~벽 솔리드 다리(bridge)로. 나사가 솔리드 안으로만 지나감
    다리는 단면중앙(전체폭 채워 앞뒤 다 당김): 정크션 + 하부핸들 2. 좌 외부 카운터싱크(머리 flush)
    케이블은 다리 옆(y<28)으로 통과, IMU구간(z-34..-76) 회피
    - SS-5GL 포켓을 시임(x0)쪽으로 열어 우반쪽 열고 스위치 눕혀 삽입 → 좌반쪽이 닫음(압입+글루). 나사 제거
    - 양쪽 watertight·1조각, audit 통과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
    [grip_body_v3.stl, grip_left_v3.stl, grip_right_v3.stl]
2026-06-24 cad: 나사를 벽쪽(앞뒤) 위치로 복귀 + Ø7 솔리드 튜브로 감쌈(중앙 회피)
    - 중앙 다리는 케이블 막아 NG → 벽쪽 위치(정크션뒤·하부 앞뒤)로. 가운데는 케이블 길로 비움(확인)
    - 나사를 Ø7 솔리드 튜브(벽~벽 intersect)로 감싸 cavity 노출 없음(off-axis 솔리드 확인)
    - 좌 외부 카운터싱크(표면 어디든 머리). 양쪽 watertight·1조각, audit 통과
    [grip_body_v3.stl, grip_left_v3.stl, grip_right_v3.stl]
2026-06-24 수정: 분할을 창 자른 뒤로(반쪽에 스냅창 포함) + 트레이 선반 1.2mm
    종합검증(fact-check) 결과 반영:
    - HIGH: 좌우 분할이 창 자르기 전이라 출력용 반쪽에 캐리어 스냅창 없던 것 → 분할을 assemble의 창컷 뒤로 이동. grip_left+right≈grip_body(창포함) 확인
    - MEDIUM: 허브 트레이 선반 0.5/0.6mm(FDM 최소 미달) → 1.2mm(보드 z갭 유지하며 바깥으로)
    - B-1(SS-5GL 하우징 없음)은 오판 확인: z-34 +X벽 x16-18 솔리드(레버창만 열림)
    - 8 STL watertight·1조각, audit 통과. 잔여 비블로커: M-1(조이스틱깊이 실물확인) M-2(트리거 끝스톱)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
    [grip_body_v3.stl, grip_left_v3.stl, grip_right_v3.stl]
2026-06-24 수정: 나사 한쪽만 입구(우측 블라인드) + SS-5GL 고정나사 복구
    - 우측 파일럿이 끝까지 관통해 양쪽 구멍이던 것 → 블라인드(x0..8)로. 우측 바깥 막힘(솔리드 확인). 나사는 좌측서만 삽입
    - SS-5GL 고정: 클램쉘화하며 빠졌던 나사 2개(+X 백킹벽, 피치6.4) 복구. 스위치 시임쪽서 눕혀넣고 그 나사로 벽에 고정
    - SS-5GL 버튼 완비: 포켓+고정나사+레버창+핑거패들(lift_pad). audit 통과
    [grip_body_v3.stl, grip_left_v3.stl, grip_right_v3.stl]
2026-06-24 재설계: 리프트 = 앞면 2단 트리거(중지) + SS-5GL 올바른 마운트
    - 사용자 정정: 6.4=몸체두께(홀 깊이), 마운트홀 피치=9.5, Ø2.4, 버튼 윗면
    - 리프트를 측면 패드 → 앞면 2단 트리거 레버(검지 트리거 아래, 중지가 당김)
    trigger_lift_v3: 피벗 레버, 당기면 뒤 nub이 SS-5GL 누름, SS-5GL 자체스프링 복귀
    - SS-5GL: 중앙(시임)에 캡처, 마운트홀 Ø2.4 ×2 피치9.5 ±X 두께 관통, 포켓 시임쪽 열림(삽입)
    - 레버 스윙 0~12° 그립간섭 0, 양쪽 watertight, audit 전통과. lift_pad 폐기
    [grip_body_v3.stl, grip_left_v3.stl, grip_right_v3.stl, lift_pad_v3.stl, trigger_lift_v3.stl]
2026-06-24 docs: 가이드 리프트=앞면 2단 트리거(SS-5GL 중앙 마운트) 반영
2026-06-24 cad: 리프트 2단 트리거에 토션스프링 추가 (SS-5GL만으론 레버 복귀 못함)
    - 사용자 지적: SS-5GL 내장스프링은 자기 레버만 복귀, 인쇄 레버+피벗마찰은 못 밈 → 토션스프링 필요
    - 리프트 허브 +X 축소(코일 자리 x2~6) + 그립 다리 포스트(+X보스) — 인덱스 트리거와 동일 방식
    - 레버 스윙 0~12° 간섭 0 유지, 양쪽 watertight, audit 통과. 토션스프링 2개(검지+리프트)
    [grip_body_v3.stl, grip_left_v3.stl, grip_right_v3.stl, trigger_lift_v3.stl]
2026-06-24 docs: BOM 토션스프링 2개(검지+리프트) 반영
2026-06-24 fix: PNG 한글 폰트 깨짐 수정 — matplotlib에 Noto Sans CJK KR 설정
    - 렌더 스크립트 32개에 font.family=Noto Sans CJK KR + axes.unicode_minus=False 추가
    - 한글 라벨/제목 두부(□) 깨짐 → 정상 표시. 핵심 렌더 재생성
2026-06-24 fix: 현재설계 렌더 전부 한글폰트 갱신 + obsolete lift_explain 삭제
    - grip_body/assemble/trigger_v3/trigger_spring_explain 재생성(폰트)
    - lift_explain 삭제(옛 측면리프트 → 앞면 2단트리거 trigger_lift_v3로 대체)
2026-06-24 docs: 리프트 마운트 설명 렌더 추가(lift_mount_explain)
    - SS-5GL 2나사 옆면관통(Ø2.4 피치9.5) + 레버 Φ3핀 피벗 + 토션스프링 명확히 표시
    - 구멍 2개 다 확인(z-47.25 & -56.75), 단면이 x=0이라 안보였던 것
2026-06-24 fix: SS-5GL 마운트 조립가능하게 재설계 — 내부고정(크래들+18%틸트, 시임서 나사)
    문제(사용자 지적): 기존 ±X 관통홀은 (1) x±12까지만 뚫려 바깥(12.4)을 못 넘어 나사 삽입 불가, (2) 시임 가로질러 좌우 비대칭.
    수정:
    - 손잡이가 깊을수록 +Y로 휘어(셸 얇음) → 스위치 자리에 솔리드 크래들 국부충전(나사 물릴 재료 확보)
    - 포켓+나사 손잡이곡률(18%) 틸트 → 위/아래 나사 둘다 벽 안
    - 나사축 X평행 유지: 시임(-X)서 +X로 박아 +X반쪽 셀프탭 파일럿에 고정(블라인드), 머리는 -X 카운터보어에 묻혀 -X반쪽이 덮음 → 외부구멍 0, 양쪽 접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
2026-06-24 fix: SS-5GL 크래들 -X쪽 제거 → IMU 플레이트 부착 공간 확보
    사용자 지적: 크래들(솔리드 충전)이 IMU(-X벽)를 막음. 어차피 나사고정이니 벽 불필요.
    - 크래들을 +X쪽만 작게(나사 물릴 재료)로 축소, -X 비움
    - IMU모듈↔그립솔리드 간섭 7032→46mm³ (플레이트 부착 풀림)
    - 나사머리는 -X 캐비티에 들어가 클리어(카운터보어 제거), +X 파일럿 앵커 유지
    - 레버 스윙0·watertight·audit 통과
    주의: 맨몸 IMU모듈(34x30)↔SS스위치 511mm³ 잔여충돌은 미해결(손잡이에 34mm 빈틈 없음) — 레이아웃 결정 필요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
2026-06-24 fix: IMU↔SS-5GL 충돌 해결 — SS를 +X반쪽으로 + IMU를 -X벽 리세스에 묻음(크기유지)
    사용자 선택: SS +X로 + IMU 리세스(크기 유지).
    근본원인: IMU 플레이트가 10mm 블록이라 보드를 x-9까지 밀어 +5 튀어나옴 → 중앙 SS와 정면충돌(511mm³).
    - IMU 플레이트를 -X벽쪽으로(x-18..-14) → 보드가 벽 가까이 x-11.5..-1.5(스탠드오프2.5)로 들어감
    - 보드 코너가 휜 벽을 파고드는 자리에 리세스 컷(보드는 외피 안이라 바깥 안뚫림, 외피~5mm)
    - SS-5GL을 +X반쪽(중심 x2.5)으로 이동, 파일럿/크래들/nub/레버슬롯 +X 추종
    - IMU리세스부울이 남긴 vol=0 슬리버를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
2026-06-24 refactor: 중지 리미트를 SS-5GL→작은 택트(6x6)로 단순화 (Meta Quest 그립버튼식)
    사용자 지적: left 케이스 짤림 + IMU 홀 소실(리세스 부작용). 근본은 SS-5GL이 손잡이엔 너무 큼.
    사용자 제안대로 작은 택트로 교체:
    - SS-5GL 포켓/크래들/파일럿/리세스/틸트 전부 제거 → 택트(6x6) 중앙 포켓(좌우반쪽 캡처, 나사X)
    - 중지 레버 nub이 택트 누름 + 토션스프링 복귀(Quest 그립버튼식)
    - IMU 정상 마운트 복귀(플레이트+홀), 손잡이축 따라 살짝 내려(z-61) 틸트보드 앞모서리가 택트 비킴
    - 케이스 짤림 해결(외피 정상), IMU 홀 복구, lift_mount_explain(SS전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
2026-06-24 fix: 리프트 트리거를 손잡이 앞면 곡률에 맞춰 재배치 + 손잡이 20mm 연장(IMU 충돌 해결)
    사용자 지적: 리프트 레버가 손잡이 앞으로 ~9mm 떠있었음(손잡이가 곡률로 휘는데 무시).
    - 손잡이 곡률(18°) 계산: 깊을수록 앞면이 +Y로 휨(z-36 y-1.5 → z-58 y6)
    - 리프트 트리거(피벗·레버·택트·슬롯) 전체를 18° 틸트해 앞면에 붙임 → 패드가 앞면 곡률 따라가 손가락 접근 OK, 허공X
    - 레버 직접식(패드 뒷면이 택트 직접 누름), 패드 x±3로 택트포켓 맞춤
    - 손잡이 92→112mm(20mm 연장) → 트리거 아래 IMU 전용구간(z-75) 확보. 하부 시임나사2·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
2026-06-24 fix: 검지(그리퍼) 트리거 풀당김 걸림 해결 — 통로 슬롯 +Y 확장
    검지 트리거가 풀당김(16°)서 헤드-손잡이 경계 앞벽을 침(47mm³). 슬롯을 y-18까지 확장 → 전구간(0~16°) 그립간섭 0.
    검지 갭 5.5→3.1mm(아날로그 그리퍼) 풀스트로크 확보.
    두 트리거 다 완료: 검지=자석/홀 아날로그(풀당김 클리어), 리프트=앞면 곡률 택트 직접누름. L/R watertight, audit 통과.
2026-06-26 feat: 전 부품 STEP export 추가 (Fusion 360 편집용)
    - assemble(grip_body/left/right/carrier/caps), trigger_v3(lever/mount), trigger_lift, perfboard에 .step export 추가
    - STL은 메쉬라 편집 어려움 → STEP(B-rep 솔리드)로 Fusion서 직접편집 가능
2026-06-29 fix: 리프트 트리거 피벗 안쪽 재설계 — SS-5GL 마운트 완성
    피벗을 손잡이 앞면(좁음, 보스 재료X)서 안쪽 넓은곳(y5,z-32)으로 이동 → Φ3핀 보스가 핀을 양쪽서 견고히 지지. 날(blade)은 앞 슬롯으로 나와 중지가 당김, 날 뒷면이 SS-5GL 액추에이터 누름. SS-5GL은 2나사홀(피치9.5) +X보스 셀프탭 고정. SS는 피벗 아래, IMU는 z-78로 내려 다 분리.
    검증: 핀보스 재료충분, 레버스윙0, 레버↔SS 0→106(누름), SS↔그립/IMU 0, L/R watertight, audit 통과
2026-06-29 fix: 리프트 트리거 버튼 허브 중앙정렬 (x-5..2 → x-4..4)
    허브가 -X로 치우쳐(코일자리) 날과 비대칭이던 것 → 허브를 날과 동심(x±4)으로 정렬. 토션스프링 코일 갭은 그립 +X보스(x7) 사이 3mm로 유지(코일 내경3.5~4 들어감), 그립 다리 포스트(7,5,-28)·핀 보어 그대로.
    검증: 레버중심 x0, 스윙0, 레버↔SS 0→106(누름), 코일갭+X 빔 유지
2026-06-29 fix: 리프트 레버에 토션스프링 다리 슬롯 추가 (체결점 누락 수정)
    레버에 스프링 다리 걸 곳이 없어 복귀력 전달 불가였음. 허브 +X면 앞·아래(피벗 반경~3.4)에 다리 슬롯 추가 → 레버 다리를 여기 끼움. 그립 다리는 기존 +X 포스트(7,5,-28)에. 코일은 핀 +X 갭(x4~7)에.
    검증: 슬롯 빔/보어 무손상(핀 자리 유지)/스윙0/레버↔SS 0→106/watertight
2026-06-29 fix: 리프트 레버 스프링 체결을 가짜홈→관통홀로 (끼움식)
    앞 커밋의 다리 슬롯은 그냥 파인 홈이라 다리가 얹히기만 하고 빠짐(체결 아님). 날을 관통하는 Φ1.5 홀(X축, 핀아래 반경6.4)로 교체 → 다리 끝을 끼워 관통시키고 끝 살짝 꺾으면 안 빠짐. 복귀력 제대로 전달.
    검증: 홀 관통(x-3/0/3 빔)/주변 솔리드/보어무손상/스윙0/레버↔SS 0→106/watertight
2026-06-29 fix: 검지 트리거 레버도 스프링 다리 관통홀 추가 (리프트와 동일 누락)
    검지(그리퍼) 레버도 코일갭·그립포스트는 있는데 레버 다리 걸 곳이 없었음. 날 관통 Φ1.5 홀(X축, 피벗 반경5.5) 추가 — 자석포켓(z-18)·보어 회피. 두 트리거 모두 스프링 3요소(코일갭+레버홀+그립포스트) 완비.
    검증: 홀관통/주변솔리드/보어·자석포켓 무손상/watertight/audit 통과
2026-06-29 fix: 양 트리거 그립쪽 스프링 다리를 포스트(밀착)→홀(끼움)로
    그립쪽도 다리가 밀착만 되던 포스트라 빠짐. +X 보스에 Φ1.5 홀 뚫어 코일 +X끝 다리를 끼워 고정(검지 y-23 보스안쪽, 리프트 z-28). 이제 양 트리거 모두 레버다리=레버 관통홀, 그립다리=그립 보스홀로 양끝 다 끼움식.
    검증: 양 그립홀 빔+인클로즈/핀보스 무손상/watertight/audit 문제없음
2026-06-29 fix: 그립쪽 스프링 홀도 블라인드→관통 (끝 꺾어 걸리게)
    블라인드 홀은 다리가 그냥 빠짐. 양 트리거 그립 보스홀을 관통(리프트 x6..11, 검지 x7..12)으로 → 다리를 끼워 반대쪽으로 빼고 끝을 꺾으면 걸려서 안 빠짐. 이제 4개 홀(레버2+그립2) 전부 관통식.
    검지 트리거 확인: 레버홀 관통·그립홀 관통·핀보스 무손상 OK.
    검증: 4홀 양끝 빔(관통)/외부표면 무손상/watertight/audit 문제없음
2026-06-29 feat: 미관 스무딩을 현재 형상 기준으로 재생성 (smooth_form.py)
    stale controller_v3.stl 로드 대신 현재 외형(head∪handle, 손잡이112·틸트18)을 직접 빌드해 복셀 모폴로지 스무딩(closing 블렌딩+opening 라운드+Taubin). 헤드↔손잡이 경계 블렌딩+전체 라운드된 시각 목표 controller_smooth 갱신.
2026-06-29 docs: PRINT_GUIDE 현재 설계로 갱신 (리프트=SS-5GL, 스프링=관통홀, 메타퀘스트 미관)
    리프트 트리거 택트6x6→SS-5GL(2나사 셀프탭), 토션스프링 포스트→양끝 관통홀(끼워 끝 꺾어 걺), M2나사 ~6→~8(SS-5GL 2 추가), 손가락매핑·조립순서 정정. 미관 섹션에 Meta Quest 스타일 명시.
2026-06-29 feat: 미관 타깃을 메타퀘스트 스타일로 (팜스웰 + 유기적 라운드)
    smooth_form.py에 손잡이 뒤 중하단 팜스웰(손바닥 볼륨) 추가 + opening 라운드 강화(2.5→3). 헤드+앞으로 기운 손잡이+팜스웰 = 메타퀘스트 컨트롤러식 에르고 형상. controller_smooth(시각 목표, Blender 마감용) 갱신.
2026-06-29 feat: 미관 타깃을 실제 Quest3 스캔으로 교체 (복셀 블롭 폐기)
    복셀 모폴로지 블롭(smooth_form.py)은 저해상·뚝뚝·퀘스트 안닮아 폐기. 실제 Meta Quest3 컨트롤러 스캔을 cad/ref에 넣고 미관 타깃으로 채택. PRINT_GUIDE 6 = Quest 스캔 정렬→Shrinkwrap/Sculpt 워크플로, 손잡이 굵기는 IMU 때문에 우리 치수 유지.
2026-06-30 fix: 맨밑 뒤쪽 시임 나사보스 잘림 수정 (58→52)
    하부 뒤 시임보스가 손잡이 뒤-아래 모서리(z-103서 y한계 56.5)를 넘은 y58에 있어 보스가 반쪽만 생겨 나사 안 박혔음. 손잡이축(z-103서 y40) 안쪽 y52로 이동 → Ø7 보스 안 잘리고 완전 형성.
    검증: 보스링 16/16 솔리드, 구멍 관통, L/R watertight, audit 통과
2026-06-30 feat: 리프트 레버 토션스프링 코일 케이지 (가운데 5.2mm 갭)
    허브를 Ø8 통(x±5.7)으로 넓혀 가운데 5.2mm 갭(코일 4.8실측+0.4) 파서 코일을 두 플랜지 사이에 캡처(뒤서 삽입, 핀 관통). 그립엔 허브 Ø9 회전 소켓 클리어런스 추가+핀보스 x8→9. 당김 0~10° 간섭0, 핀은 바깥보스 지지, SS 0→106, watertight, audit 통과.
    남음: 스프링 다리(레버다리=갭노치, 그립다리=소켓벽), 앞벽 충돌(-4도) 정지턱
2026-06-30 feat: 리프트 케이지 스프링 양끝 다리 슬롯 + 앞벽 충돌 릴리프
    토션스프링 양끝 고정: 레버다리=날 슬롯(레버에 키), 그립다리=Ø9 소켓 뒷벽 슬롯(그립에 키). 코일은 케이지가 축방향 잡아 다리는 슬롯 키만으로 토크 전달. 앞벽 충돌(필렛 걸림)은 그립 앞-피벗 릴리프로 파냄 → 스윙 -10~+10° 전부 0.
    검증: 스윙 전구간0, 양 다리슬롯 실재, 코일 케이지, SS 0→106, watertight, audit 통과
2026-06-30 fix: 리프트 레버 플랜지로 축방향 공간 채움 + 레버다리 슬롯 중앙정렬
    레버 허브 x±5.7→±7.0(플랜지 두께 3.1→4.4)로 넓혀 보스(x7.5)까지 갭 1.8→0.5mm — 합칠때 양옆 남던 공간/유격 제거. 보어 x±7.5 관통 연장, 그립 허브소켓 x±7.3 연장. 레버다리 슬롯 +X치우침→중앙(x±0.8).
    검증: 레버중심0, 갭0.5, 슬롯중심0, 스윙0, 핀지지, SS 0→106, watertight, audit 통과
2026-06-30 feat: 검지(그리퍼) 트리거도 토션스프링 케이징으로 통일
    리프트와 동일: 허브 Ø10 가운데 5.2mm 갭에 코일(4.8) 캡처, 플랜지로 보스까지 공간채움(x±6.5), 레버다리 슬롯 중앙, 그립다리=Ø11 소켓 뒷벽 슬롯. 자석포켓(z-18) 유지. 구 +X 관통홀 2개(리프트/검지) 제거. audit 검지 체크 갱신.
    검증: 스윙0~16°, 코일케이지, 자석무손상, 핀지지, watertight, audit 통과
